nehaej2/ece445_team39/Lab Notebooks/Ian/Written_notes.md

# Written Notes

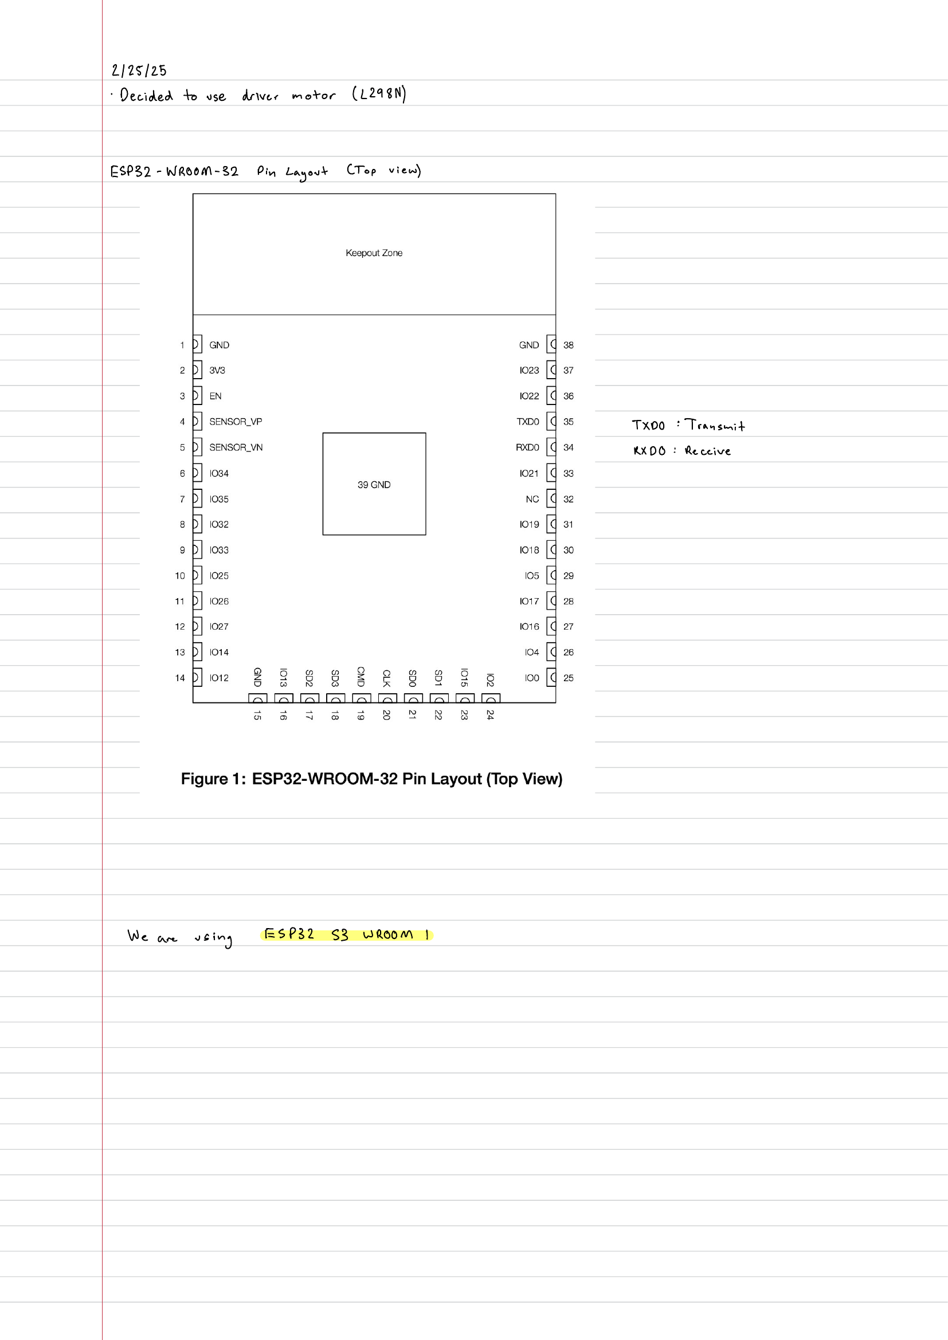
[picture p7: Lab Notebooks/Ian/Written_notes/page_1.png]
Page 1
  
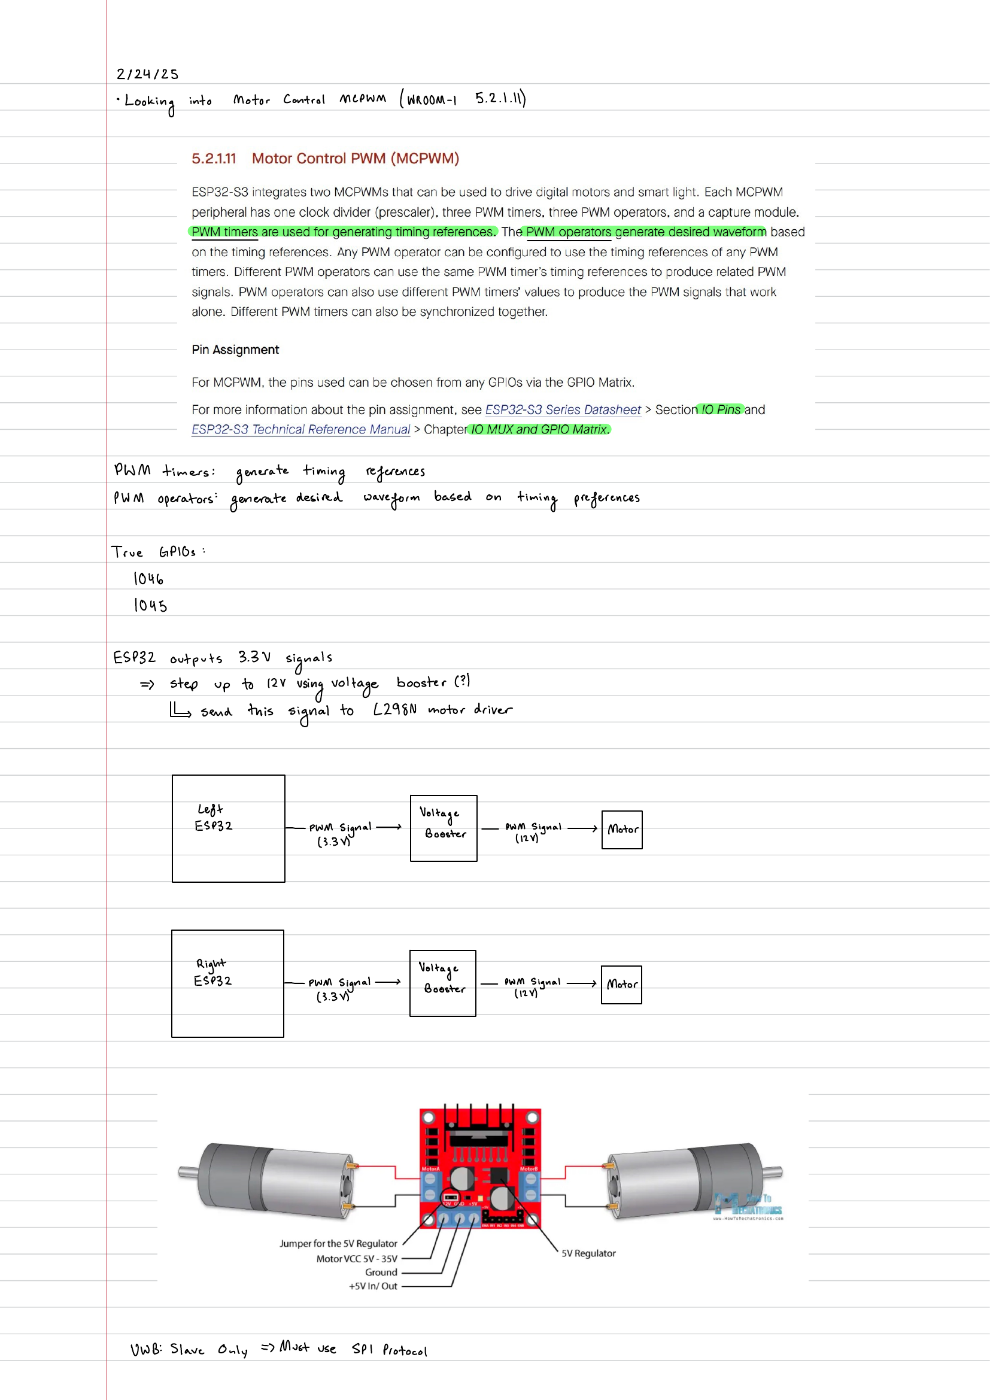
[picture p8: Lab Notebooks/Ian/Written_notes/page_2.png]
Page 2
  
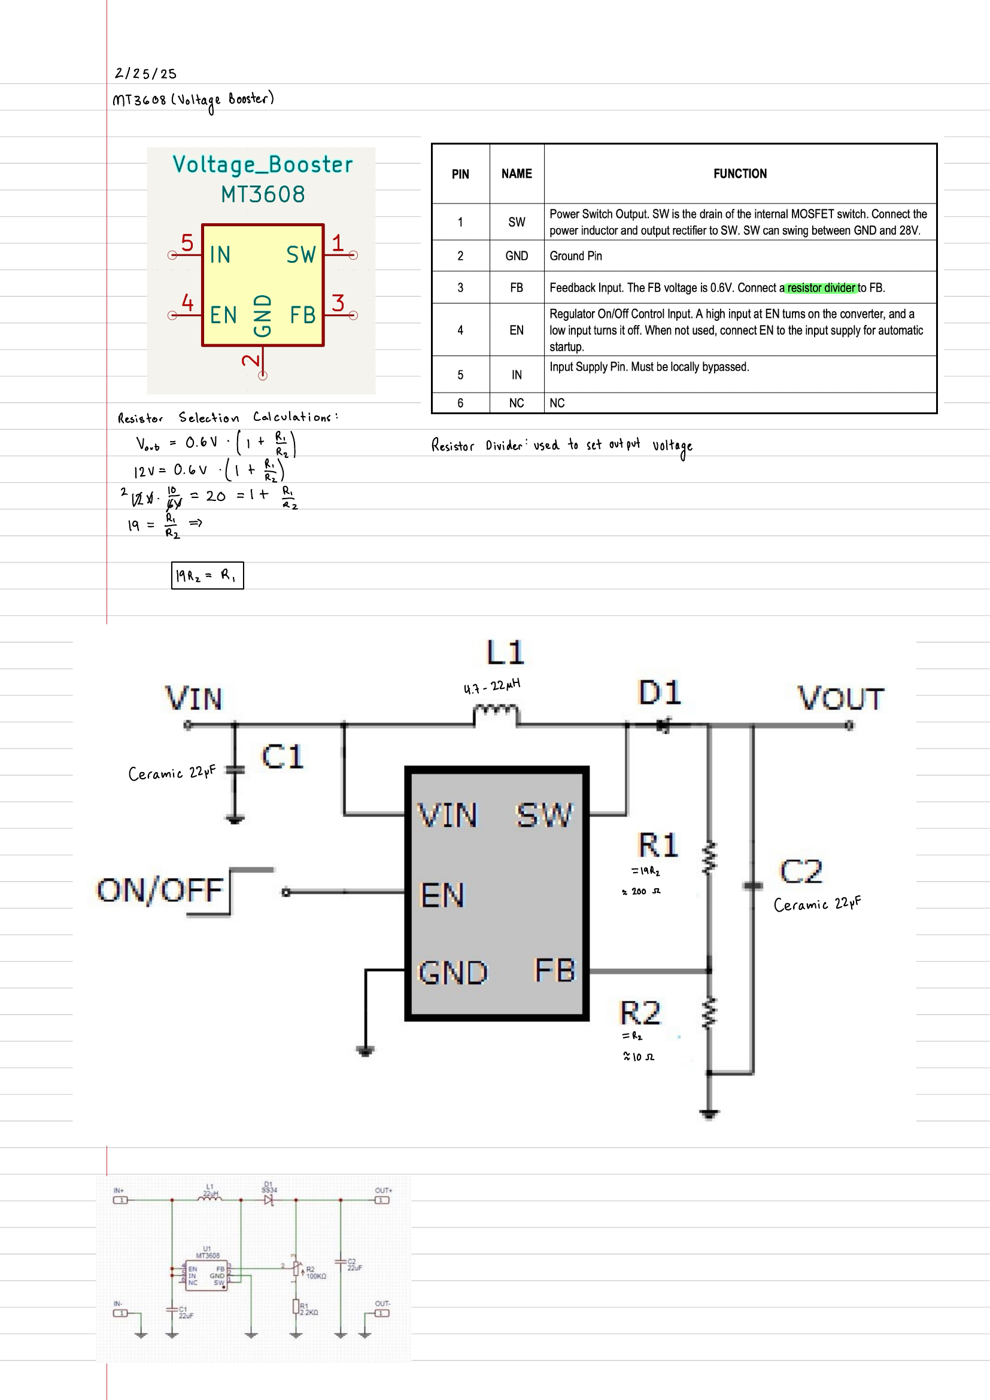
[picture p9: Lab Notebooks/Ian/Written_notes/page_3.png]
Page 3
  
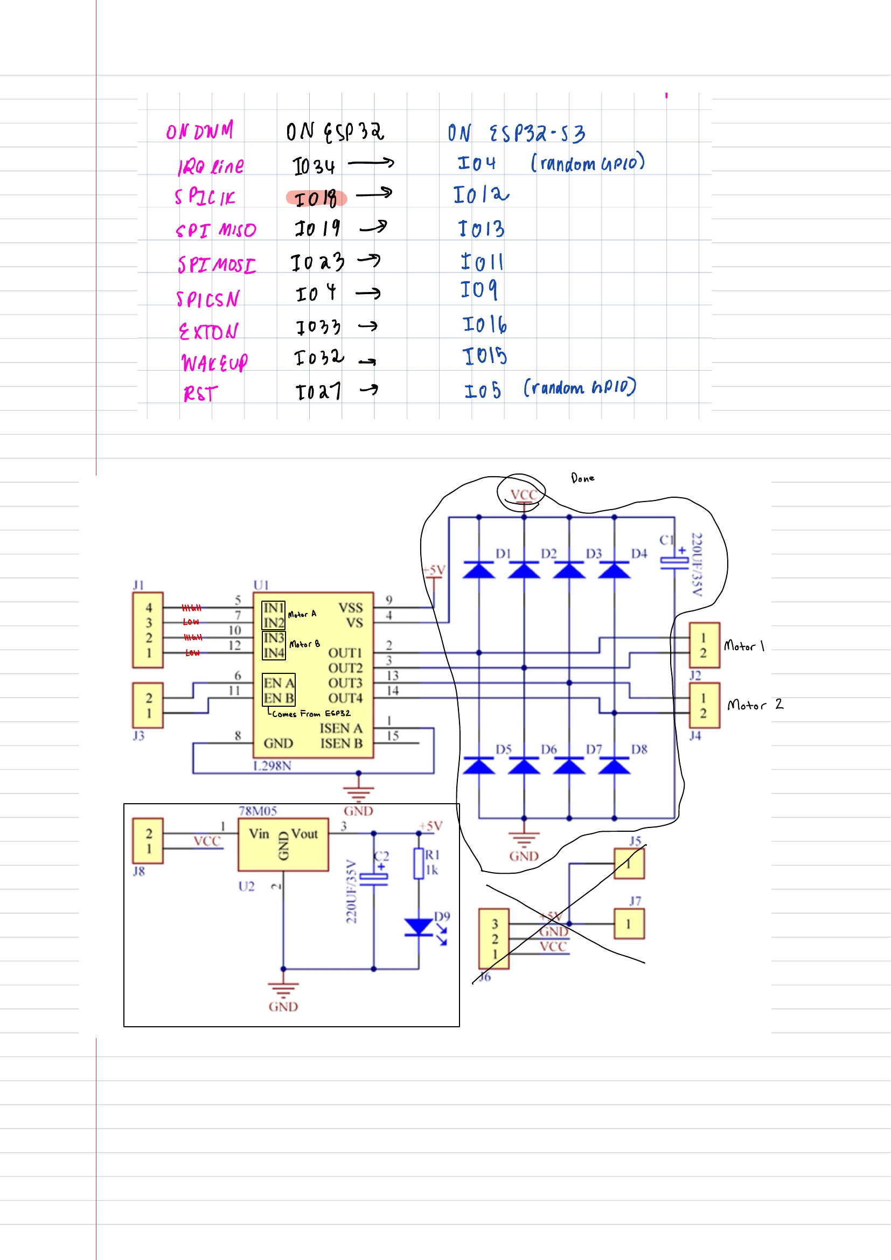
[picture p10: Lab Notebooks/Ian/Written_notes/page_4.png]
Page 4
  
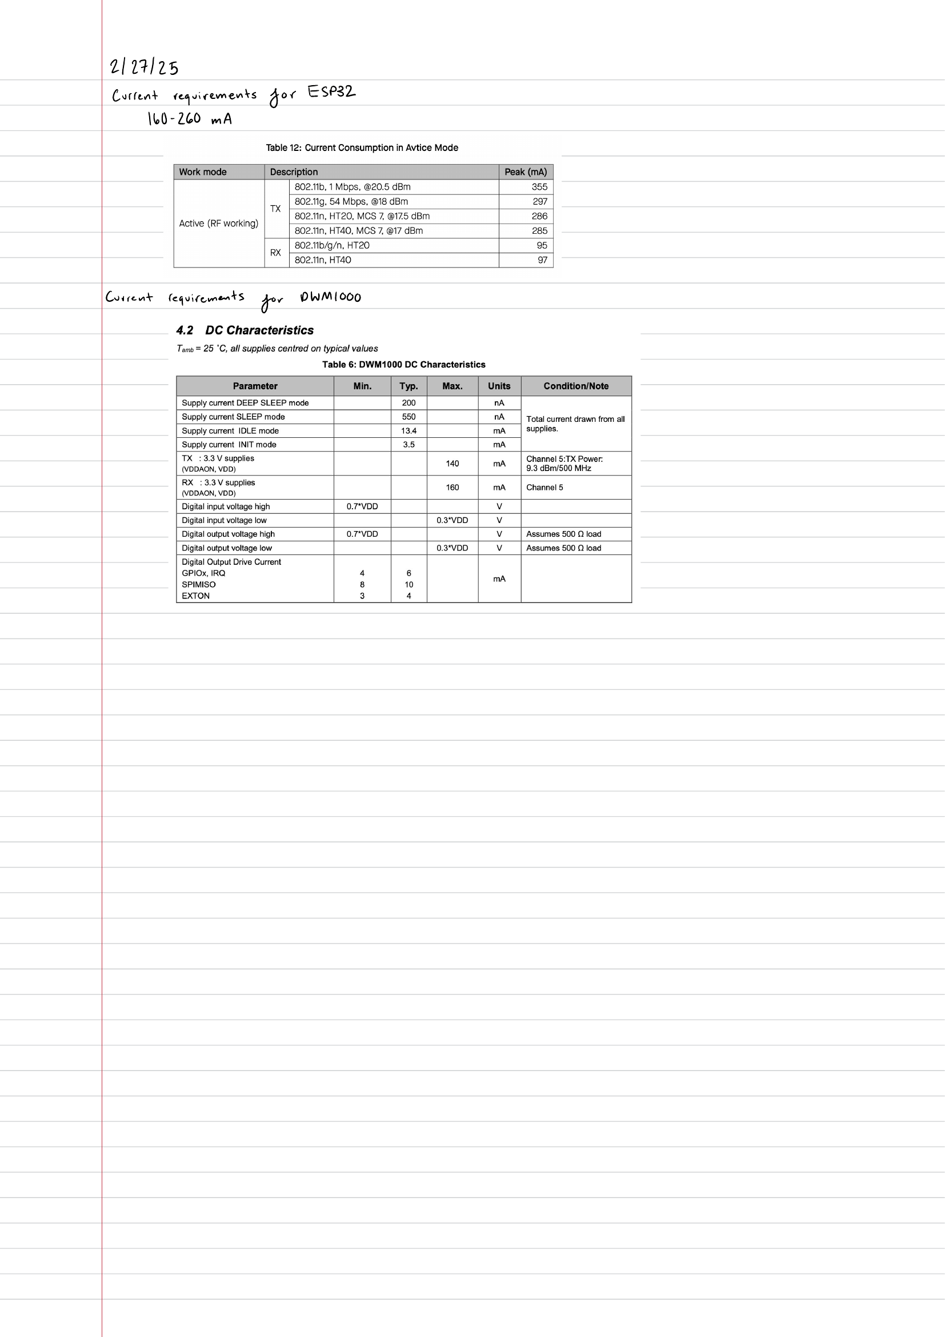
[picture p11: Lab Notebooks/Ian/Written_notes/page_5.png]
Page 5
  
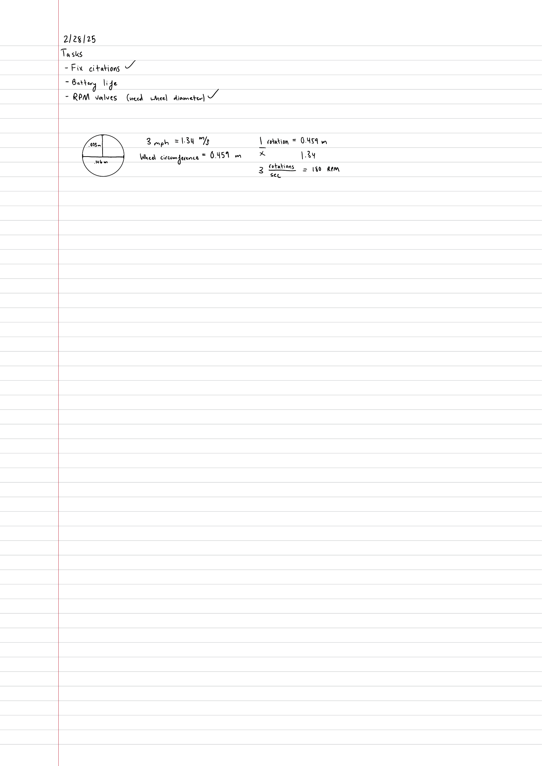
[picture p12: Lab Notebooks/Ian/Written_notes/page_6.png]
Page 6
  
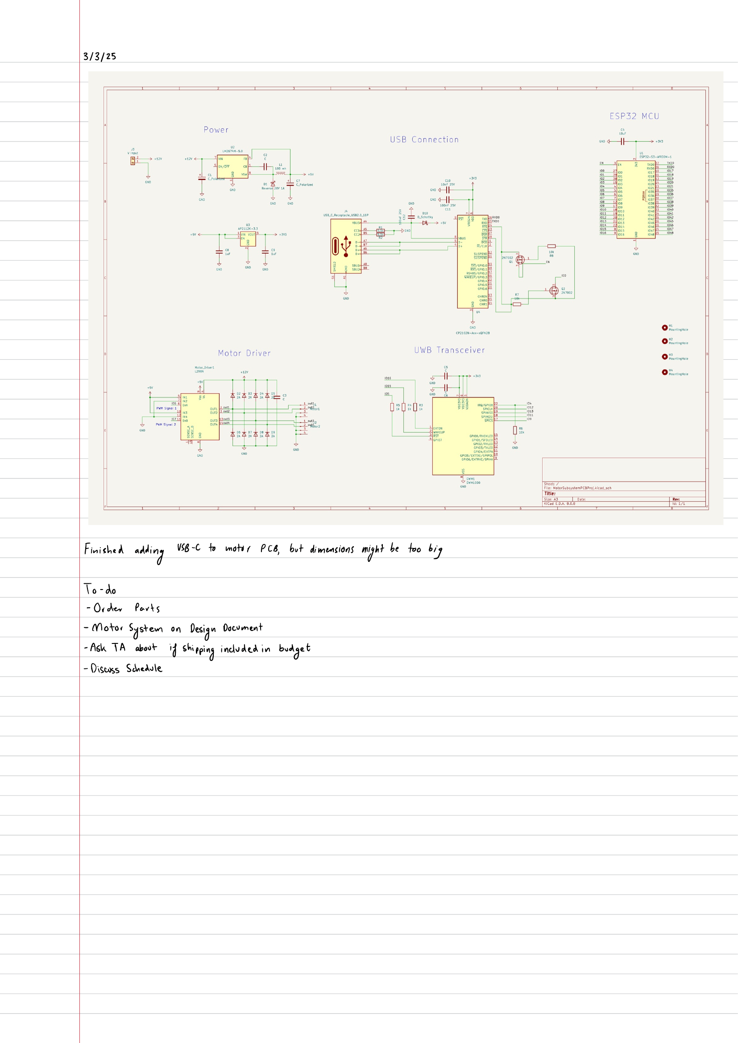
[picture p13: Lab Notebooks/Ian/Written_notes/page_7.png]
Page 7
  
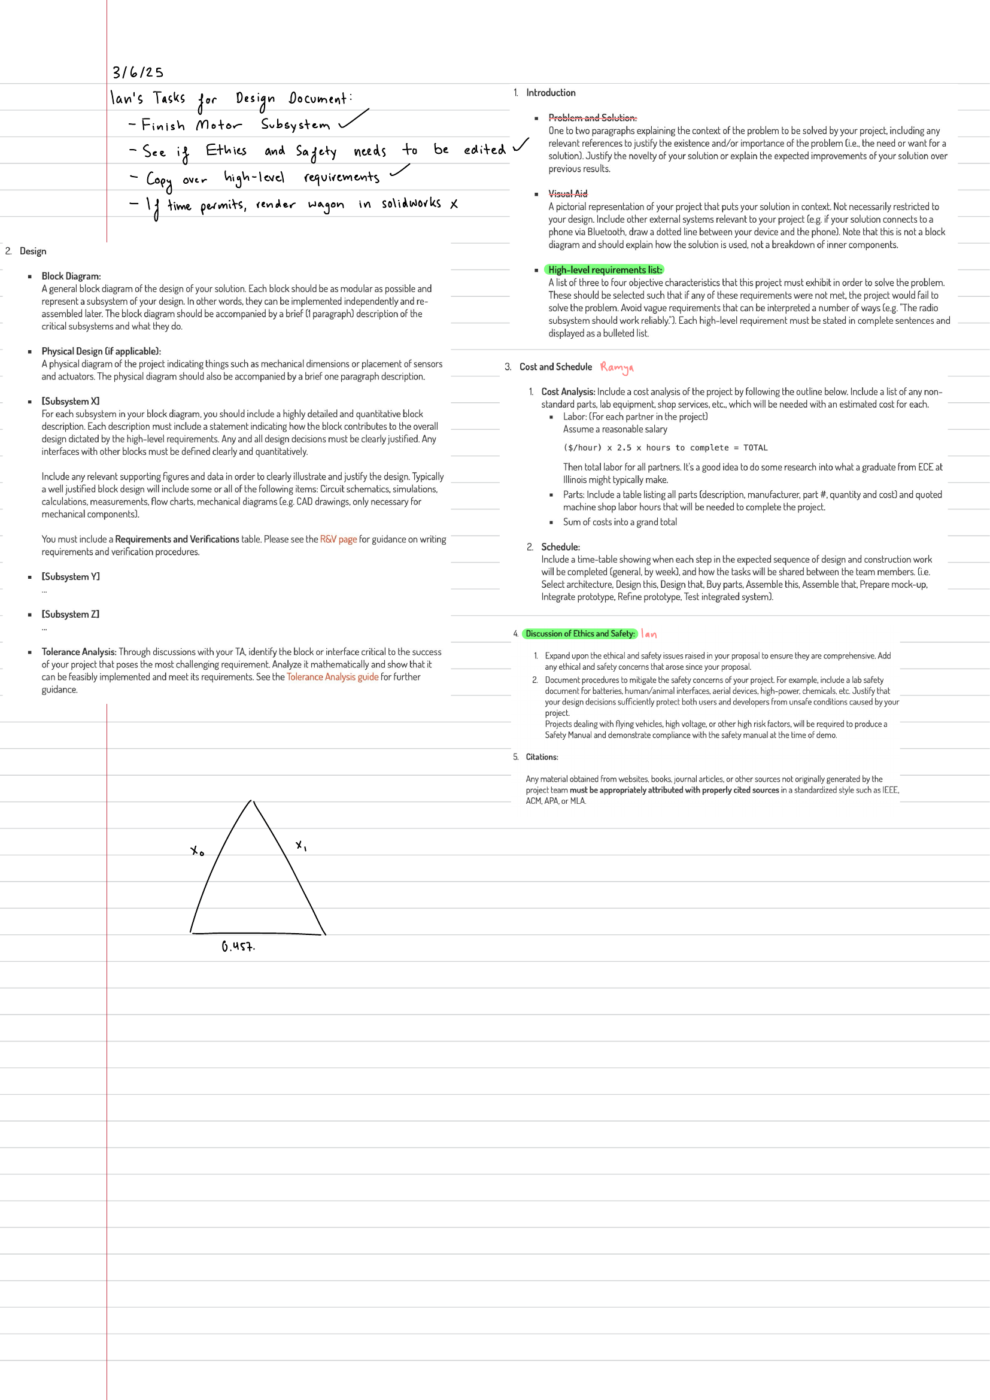
[picture p14: Lab Notebooks/Ian/Written_notes/page_8.png]
Page 8
  
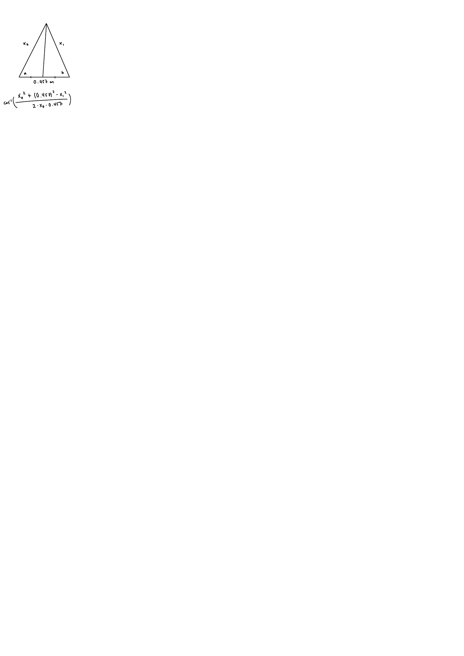
[picture p15: Lab Notebooks/Ian/Written_notes/page_9.png]
Page 9
  
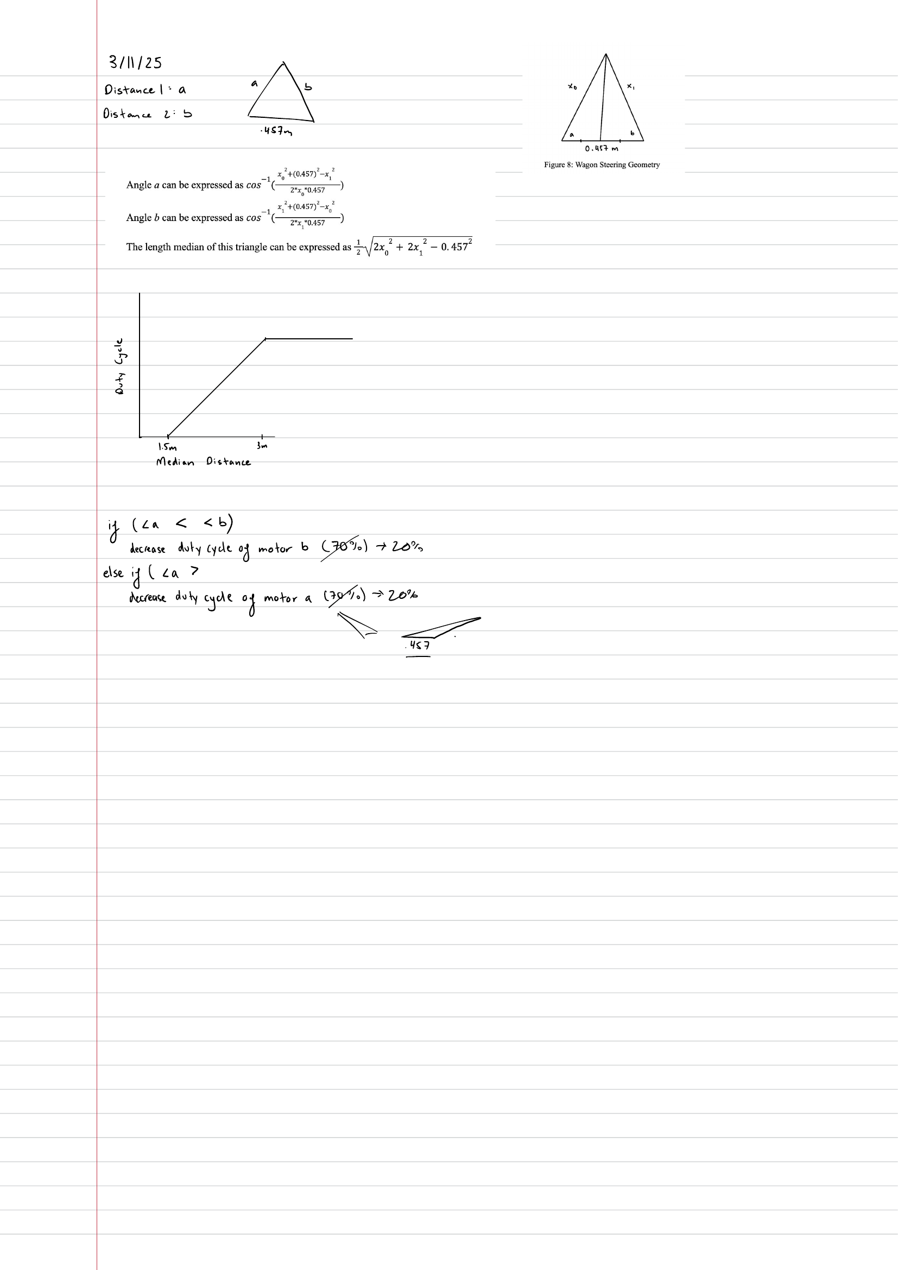
[picture p16: Lab Notebooks/Ian/Written_notes/page_10.png]
Page 10
  
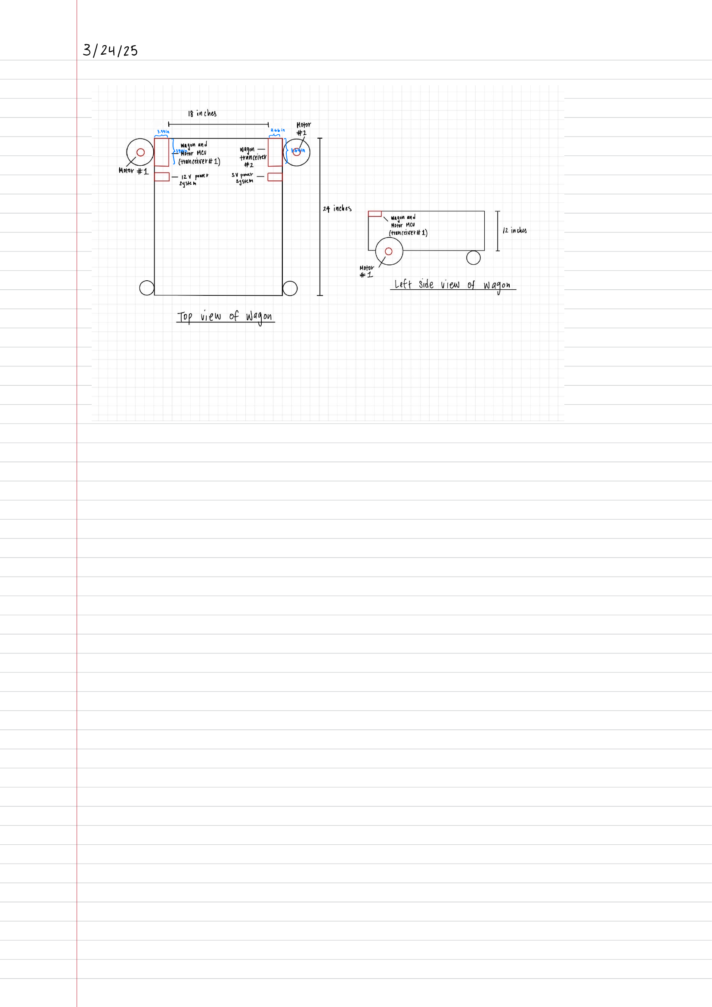
[picture p17: Lab Notebooks/Ian/Written_notes/page_11.png]
Page 11
  
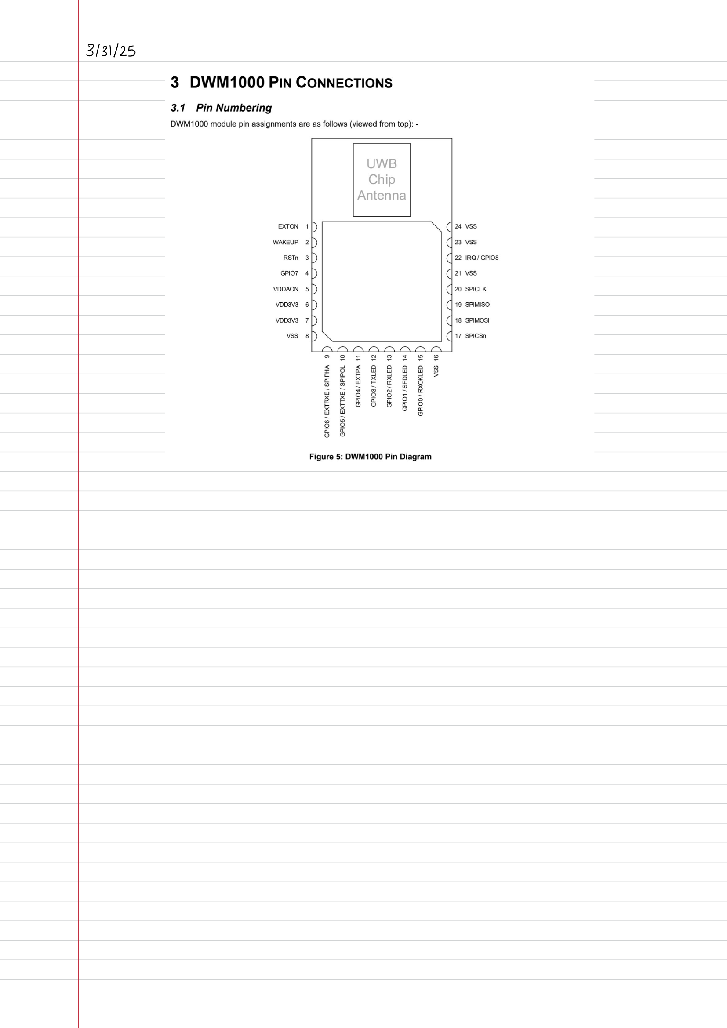
[picture p18: Lab Notebooks/Ian/Written_notes/page_12.png]
Page 12
  
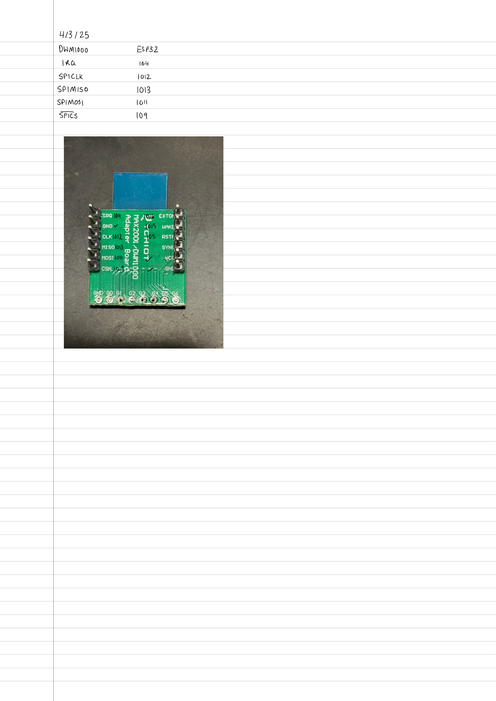
[picture p19: Lab Notebooks/Ian/Written_notes/page_13.png]
Page 13
  
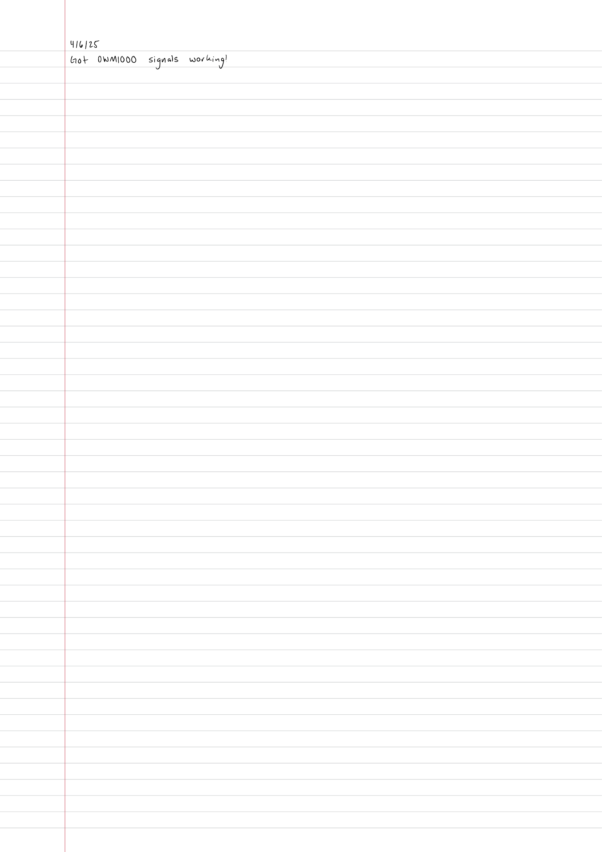
[picture p20: Lab Notebooks/Ian/Written_notes/page_14.png]
Page 14
  
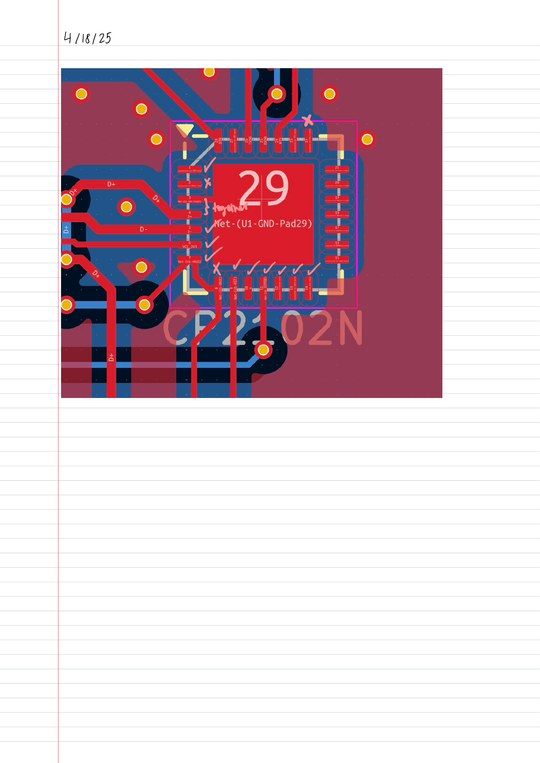
[picture p21: Lab Notebooks/Ian/Written_notes/page_15.png]
Page 15
  
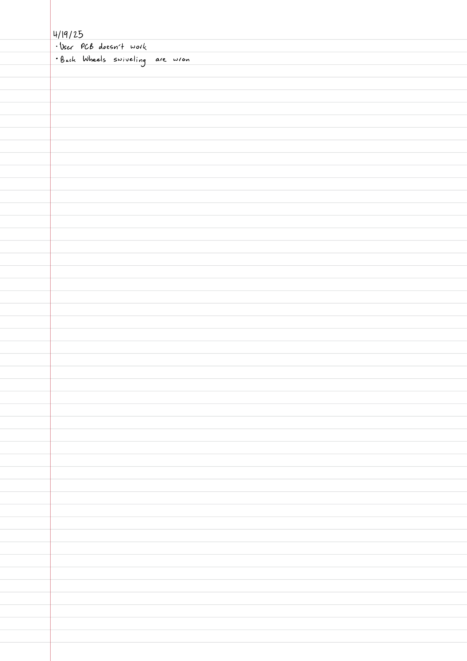
[picture p22: Lab Notebooks/Ian/Written_notes/page_16.png]
Page 16
  
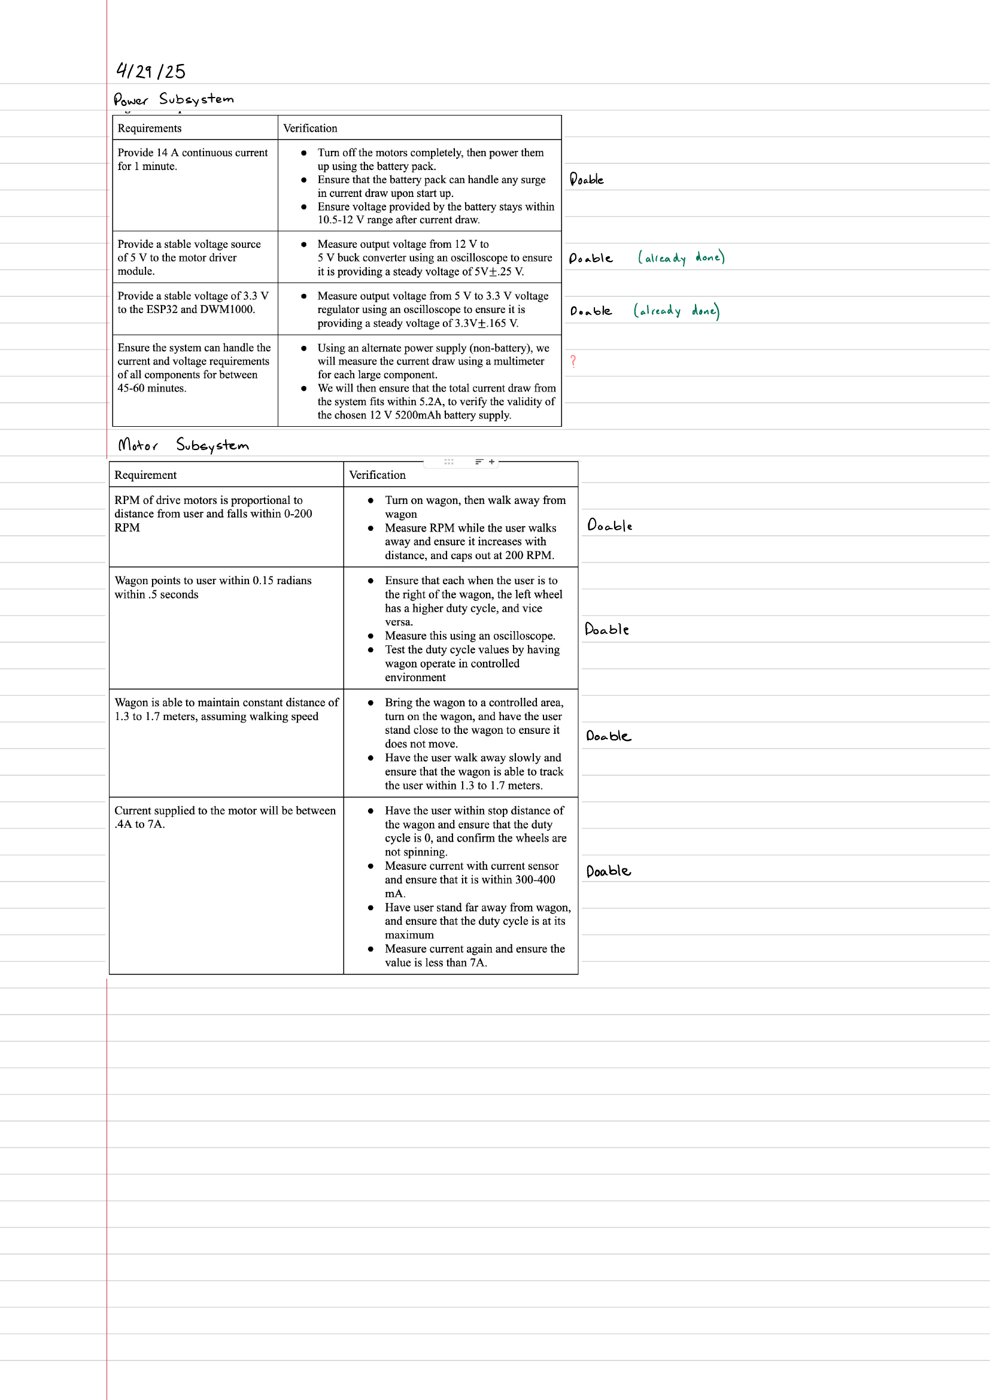
[picture p23: Lab Notebooks/Ian/Written_notes/page_17.png]
Page 17
  
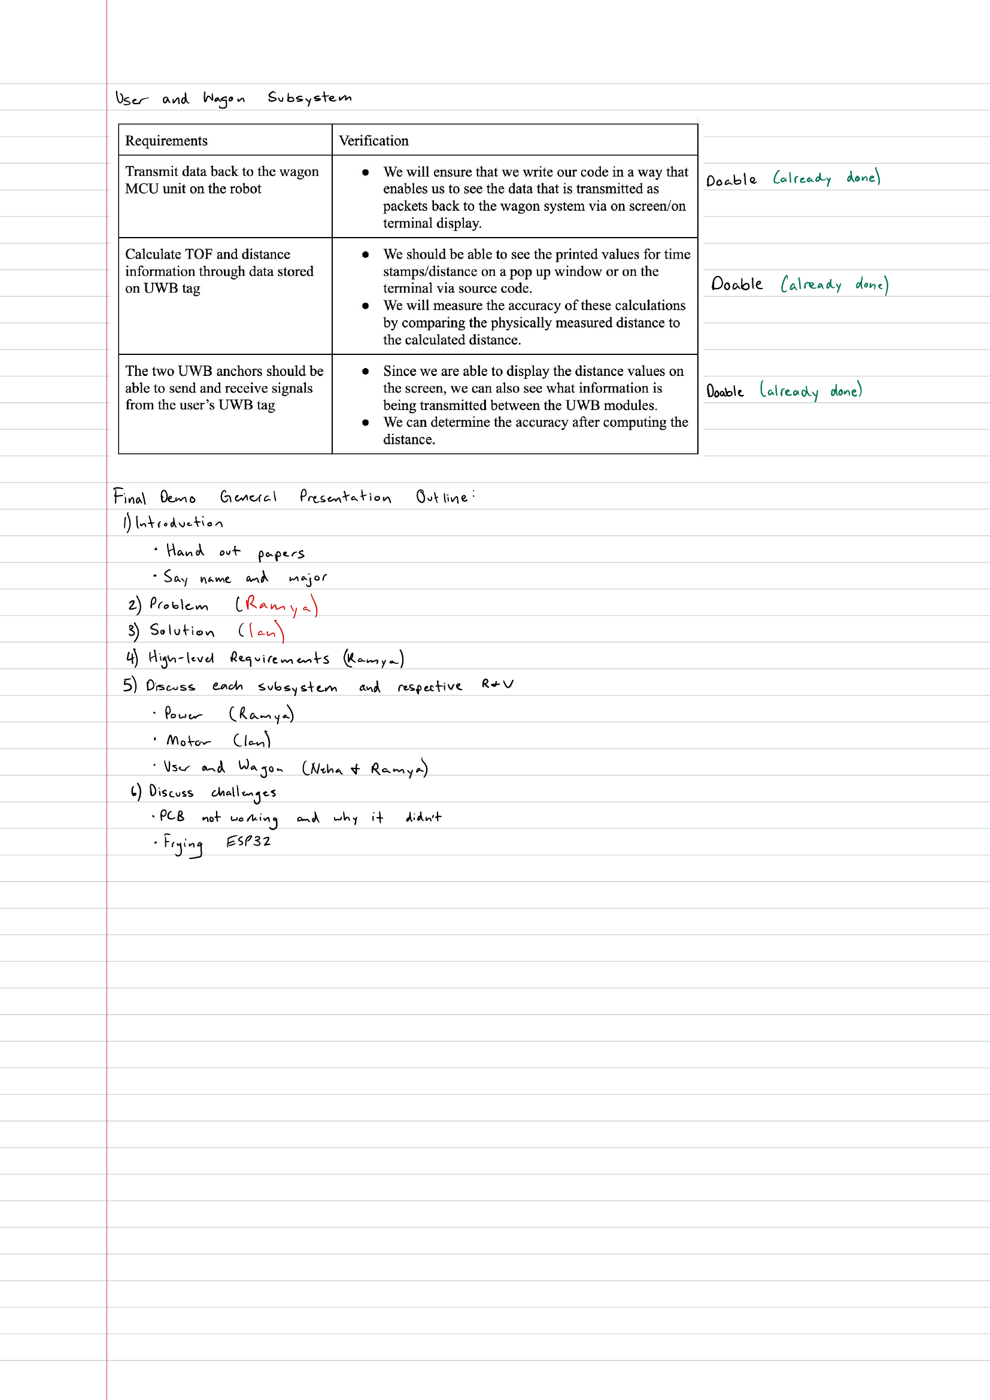
[picture p24: Lab Notebooks/Ian/Written_notes/page_18.png]
Page 18
  
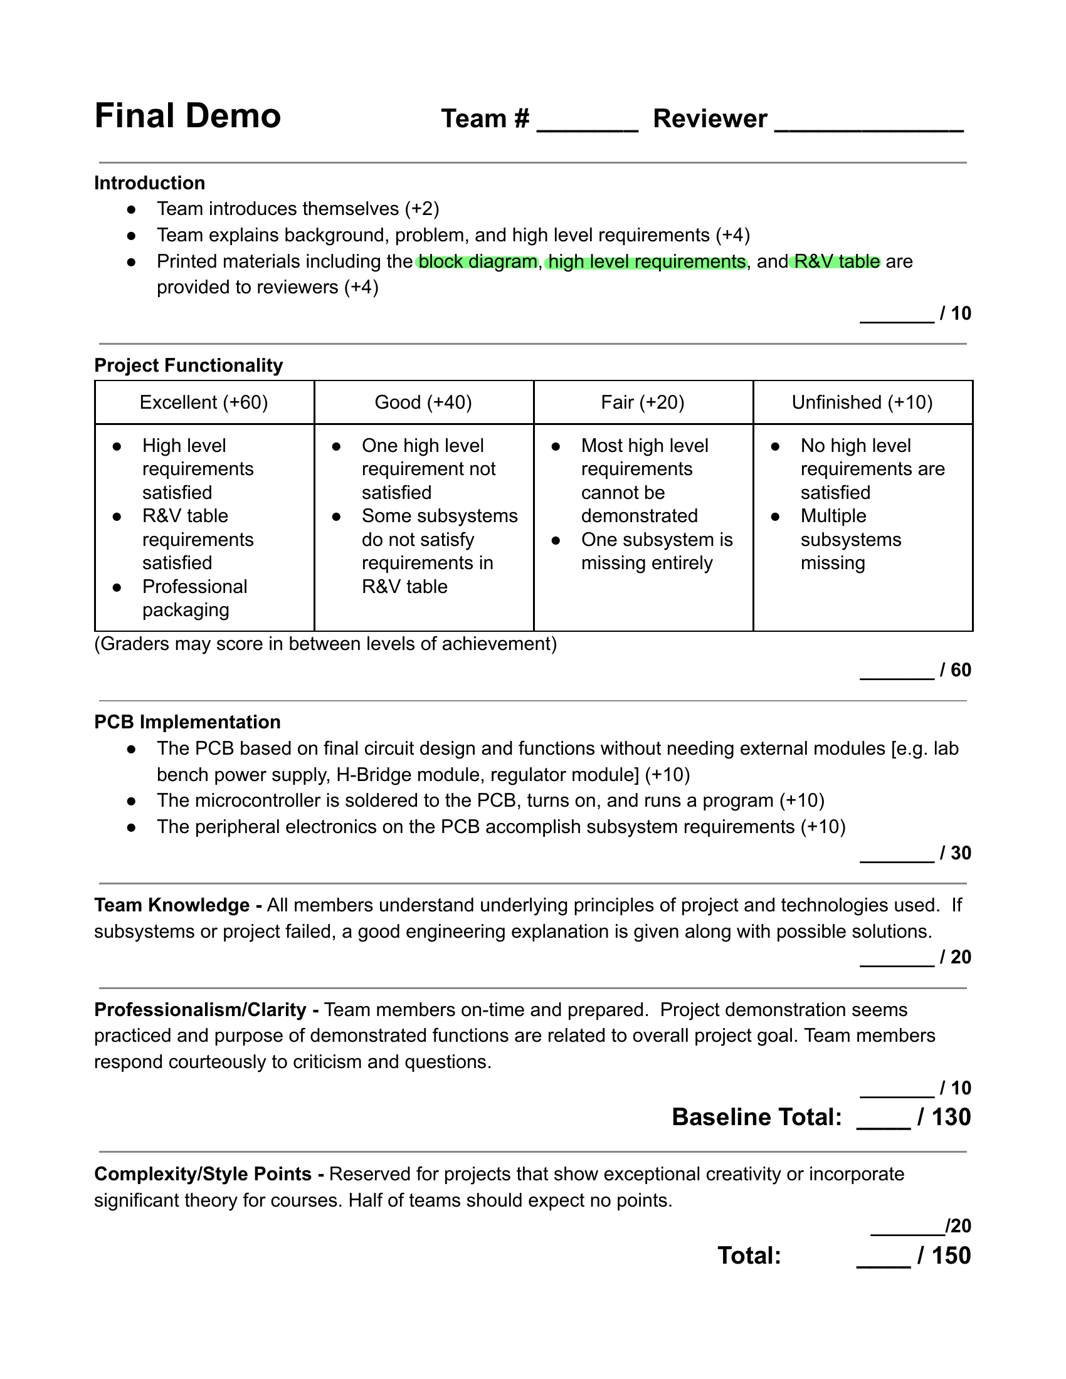
[picture p25: Lab Notebooks/Ian/Written_notes/page_19.png]
Page 19
  
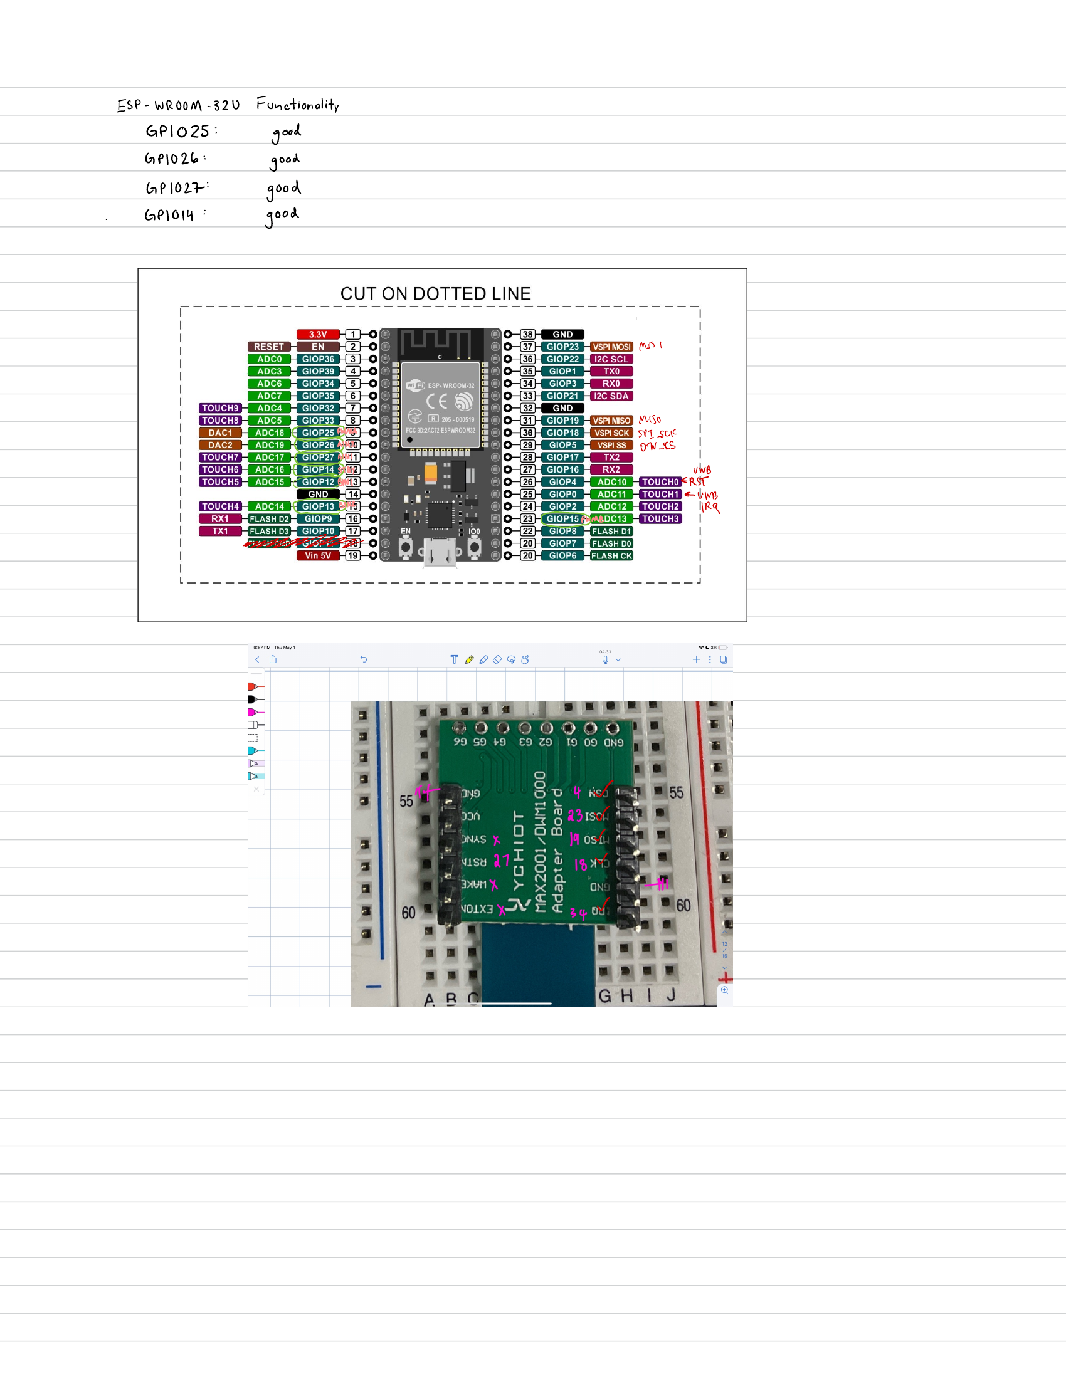
[picture p26: Lab Notebooks/Ian/Written_notes/page_20.png]
Page 20
