nehaej2/ece445_team39/Lab Notebooks/Neha/Wrtitten_notes.md

# Written Notes

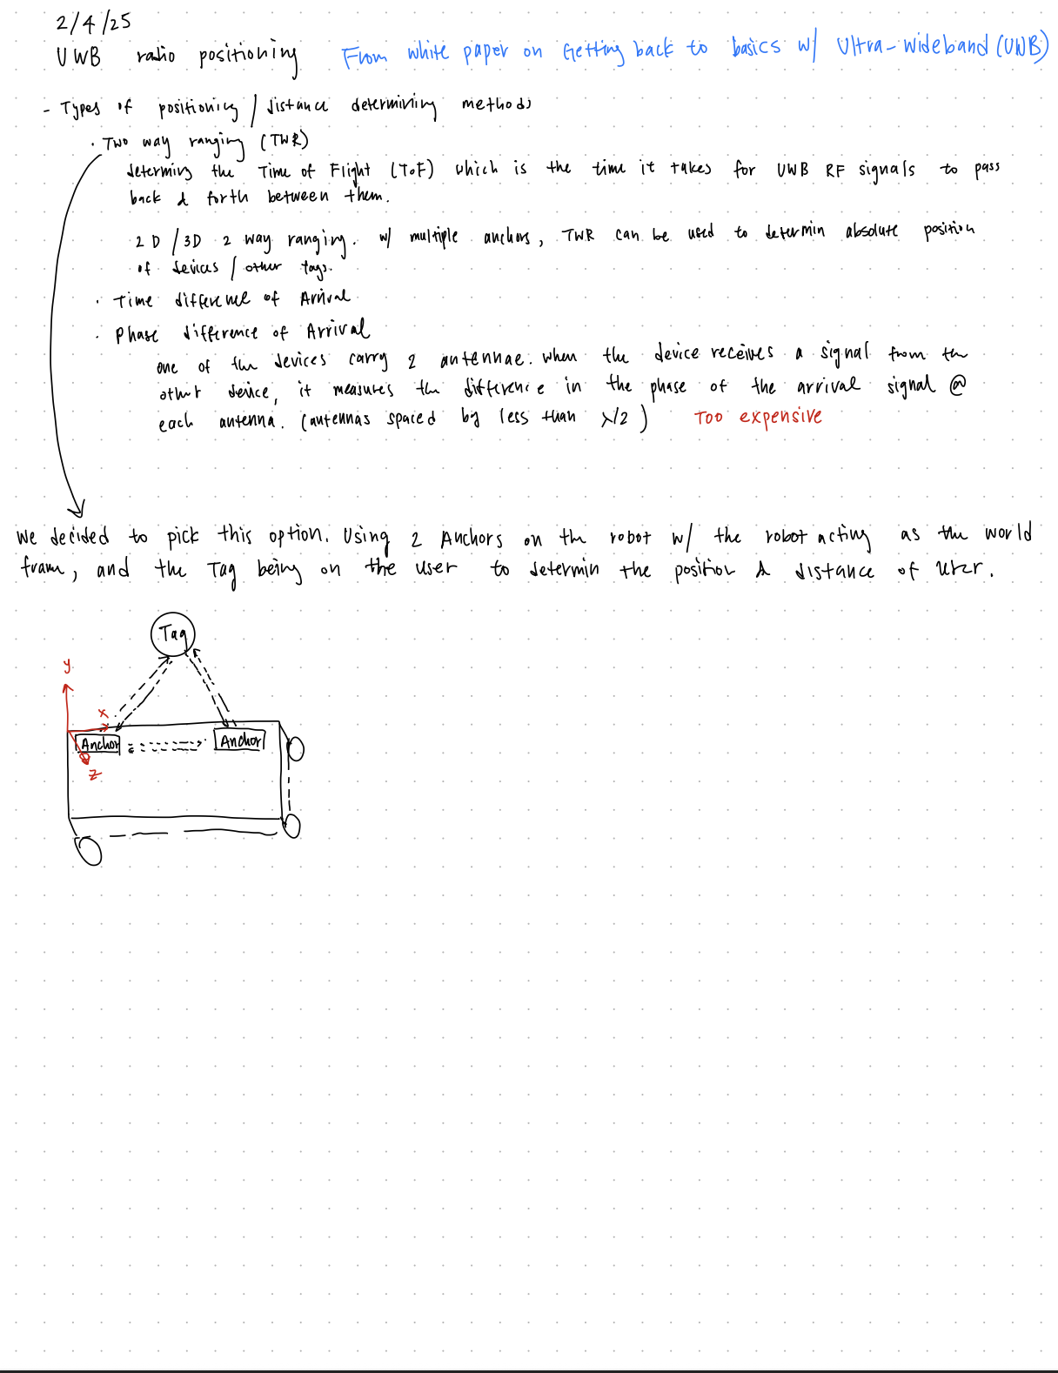
[picture p27: Lab Notebooks/Neha/Written_notes/Page_1.png]


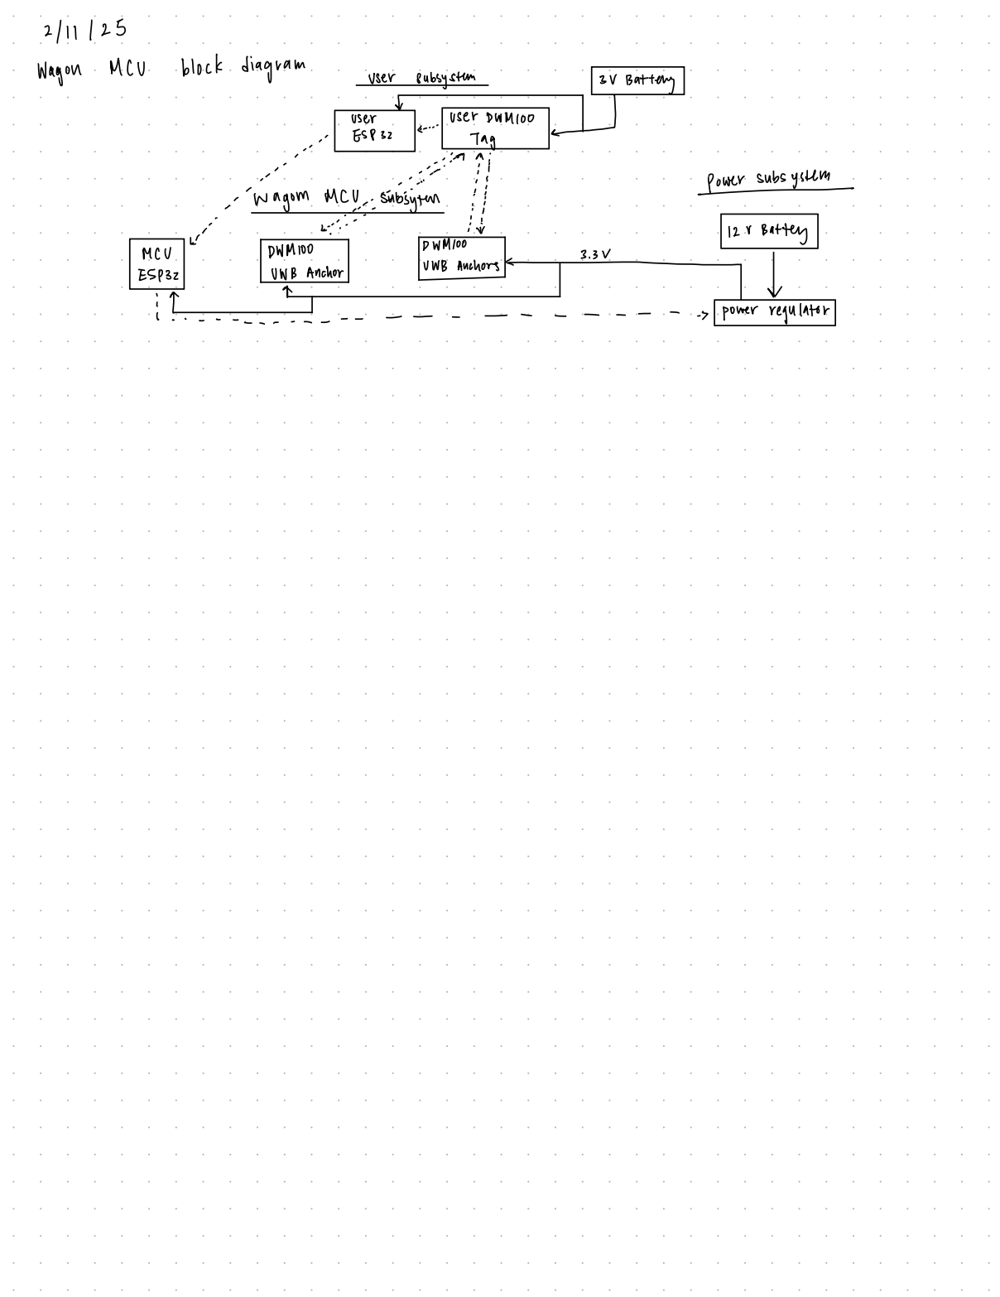
[picture p28: Lab Notebooks/Neha/Written_notes/Page_2.png]


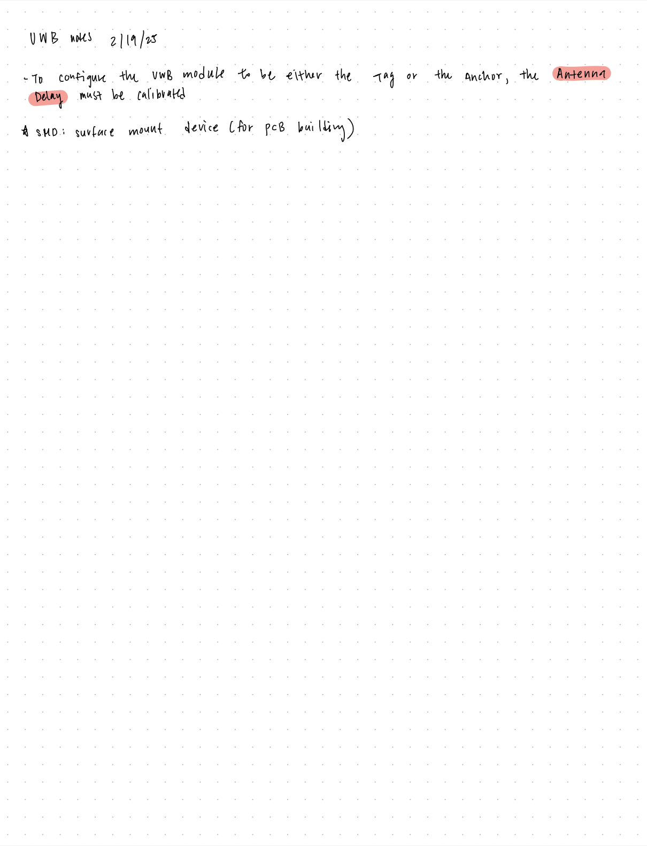
[picture p29: Lab Notebooks/Neha/Written_notes/Page_3.png]


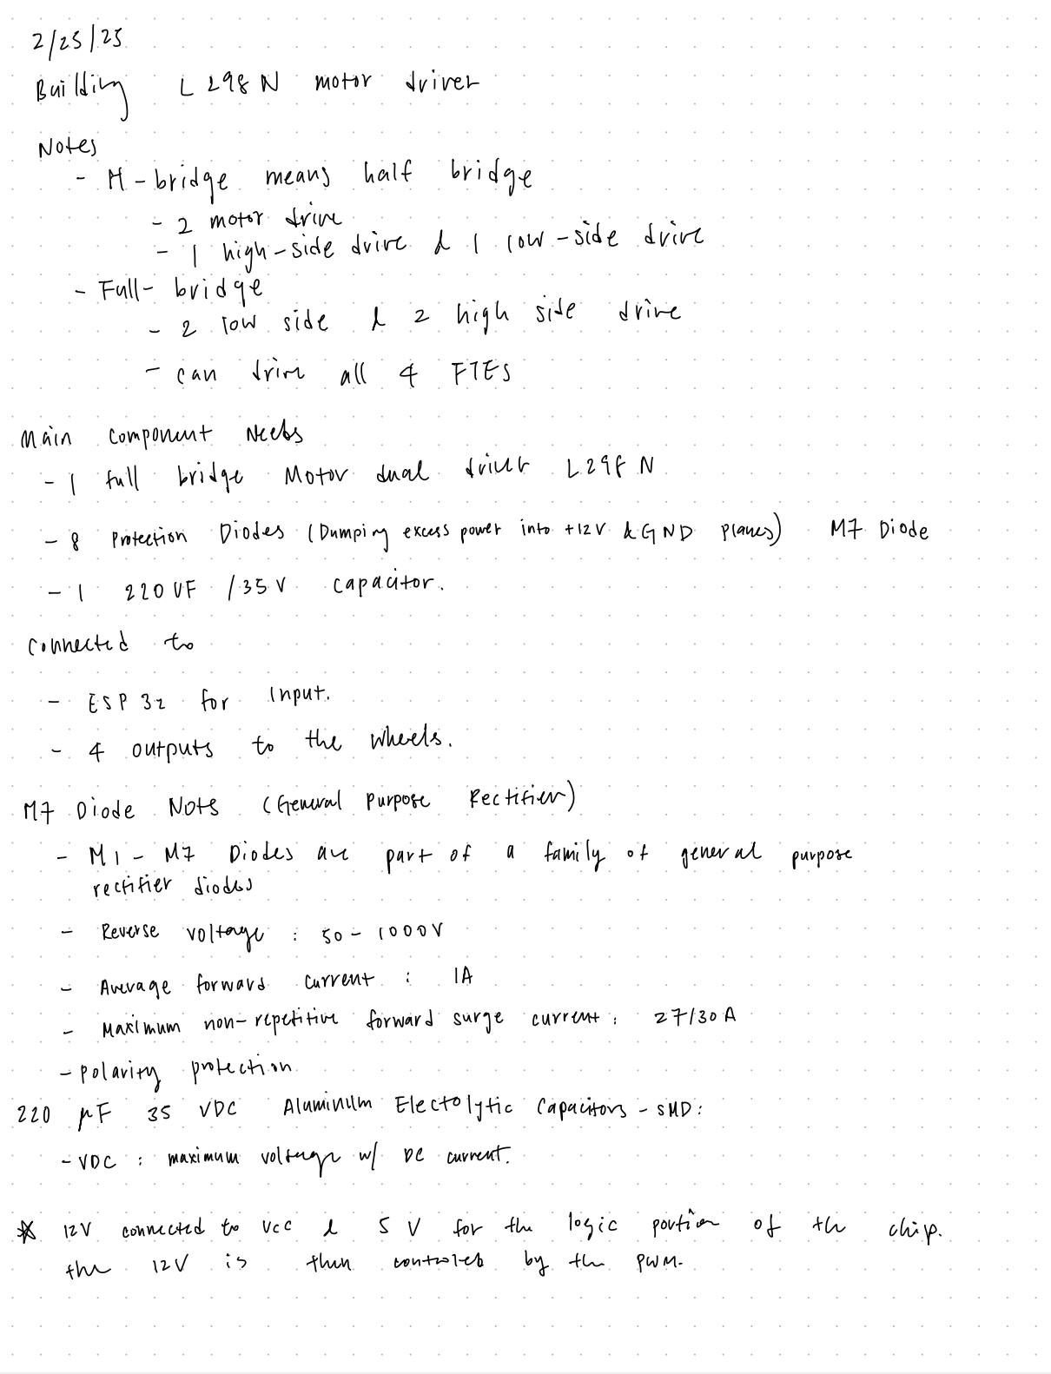
[picture p30: Lab Notebooks/Neha/Written_notes/Page_4.png]


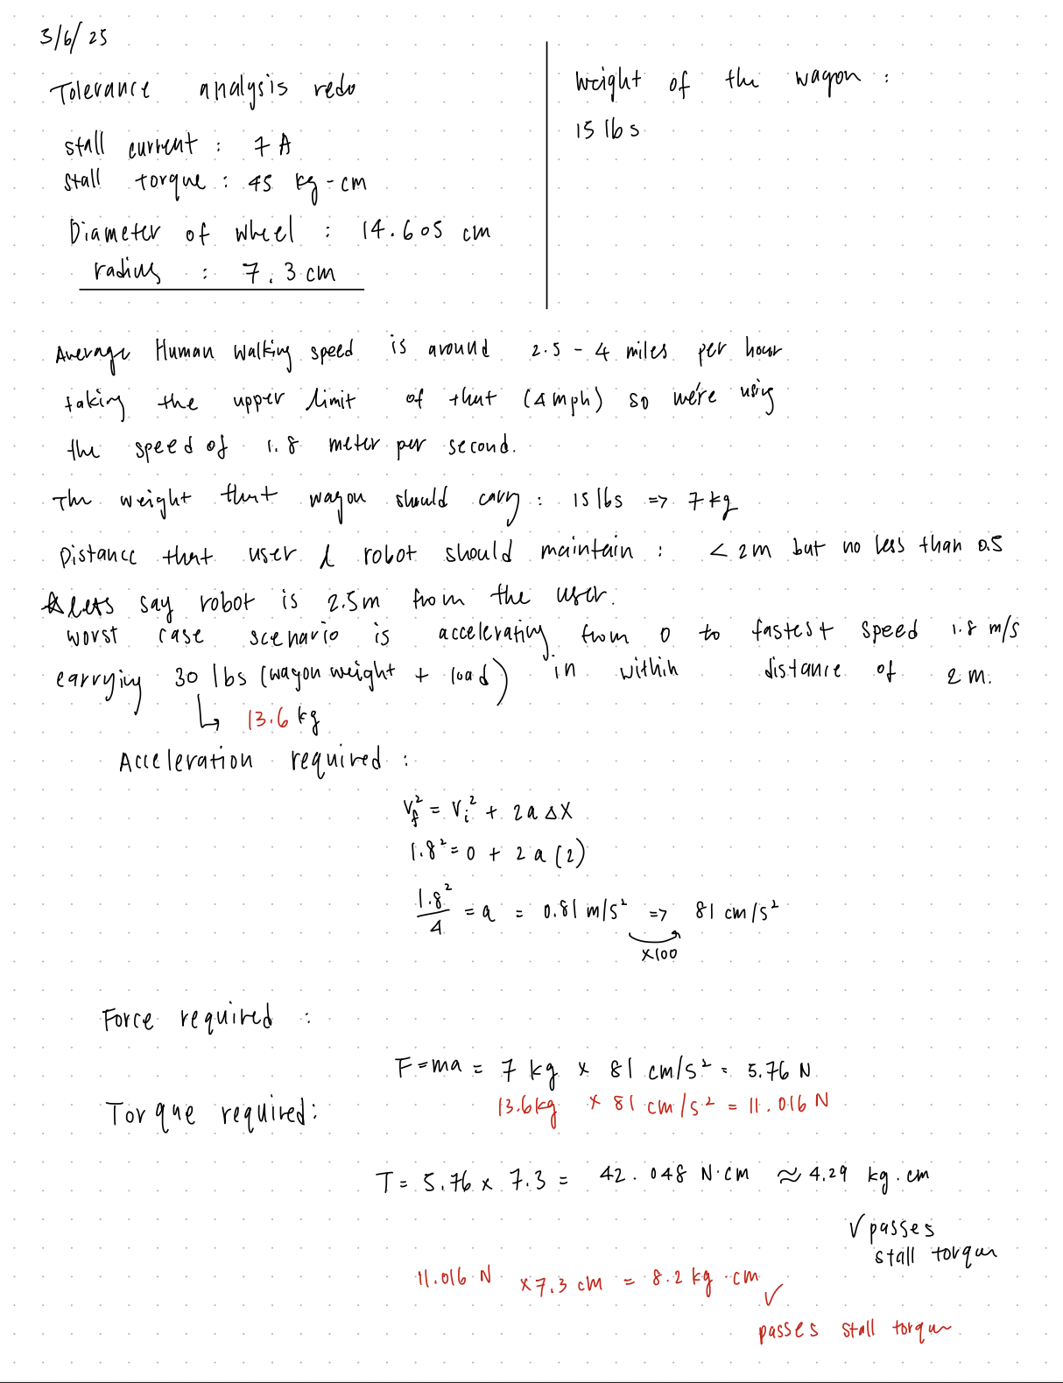
[picture p31: Lab Notebooks/Neha/Written_notes/Page_5.png]


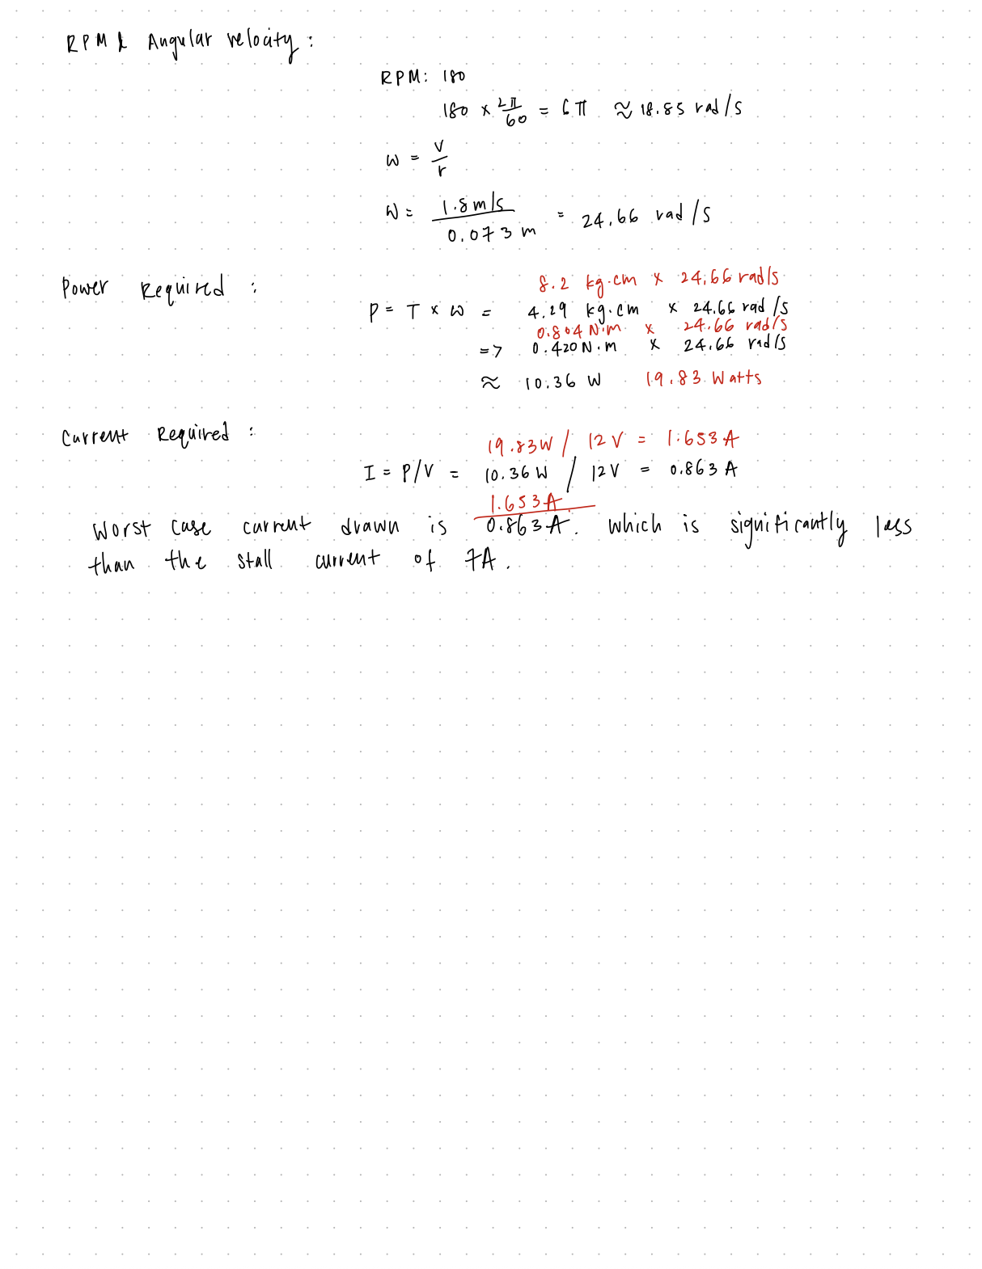
[picture p32: Lab Notebooks/Neha/Written_notes/Page_6.png]


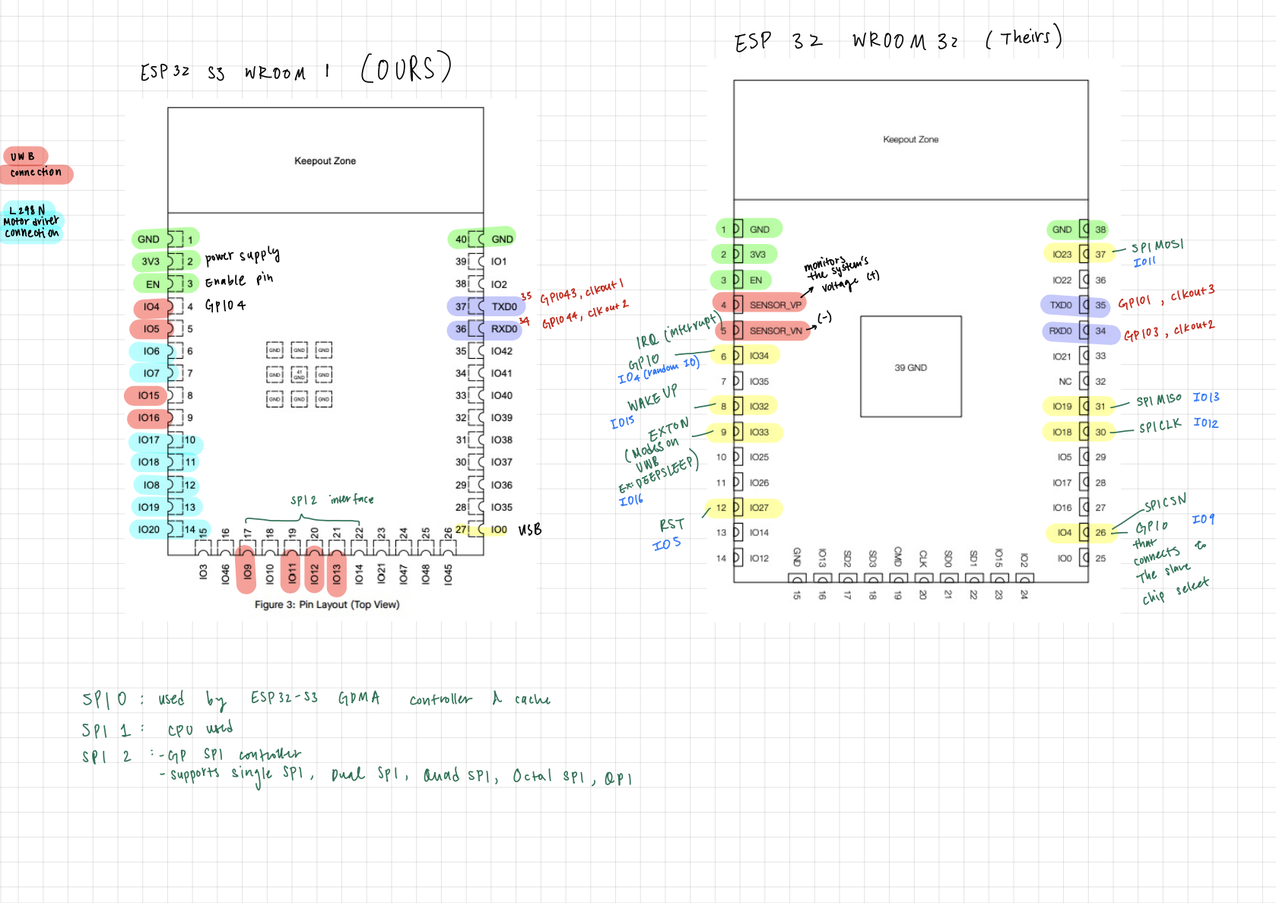
[picture p33: Lab Notebooks/Neha/Written_notes/Page_7.png]


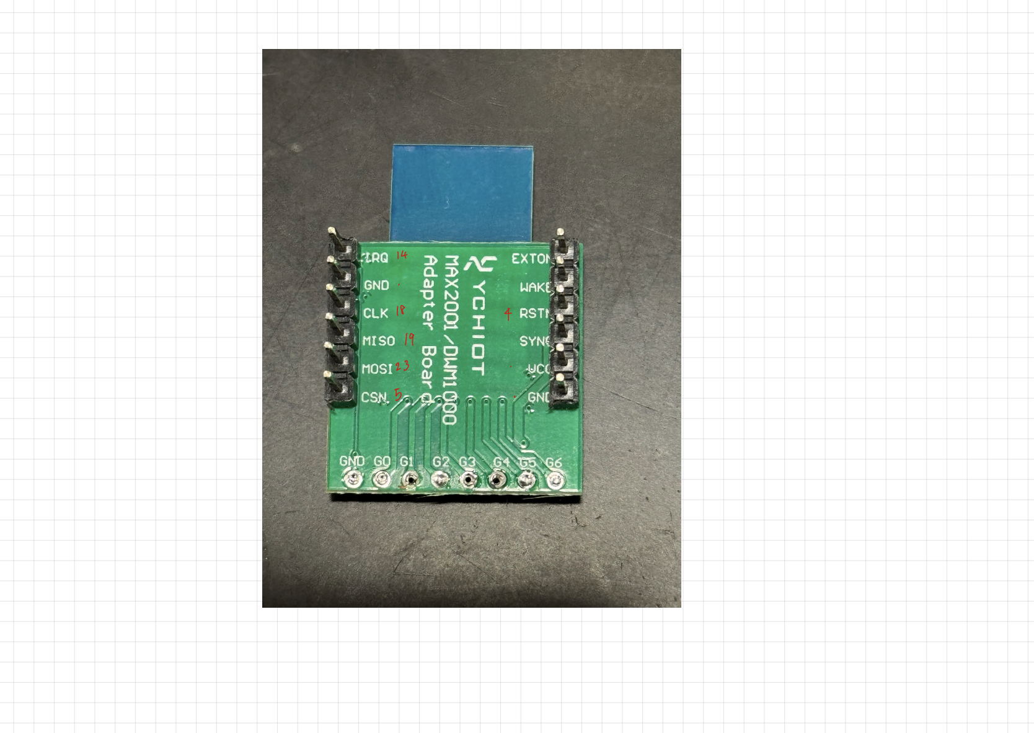
[picture p34: Lab Notebooks/Neha/Written_notes/Page_8.png]


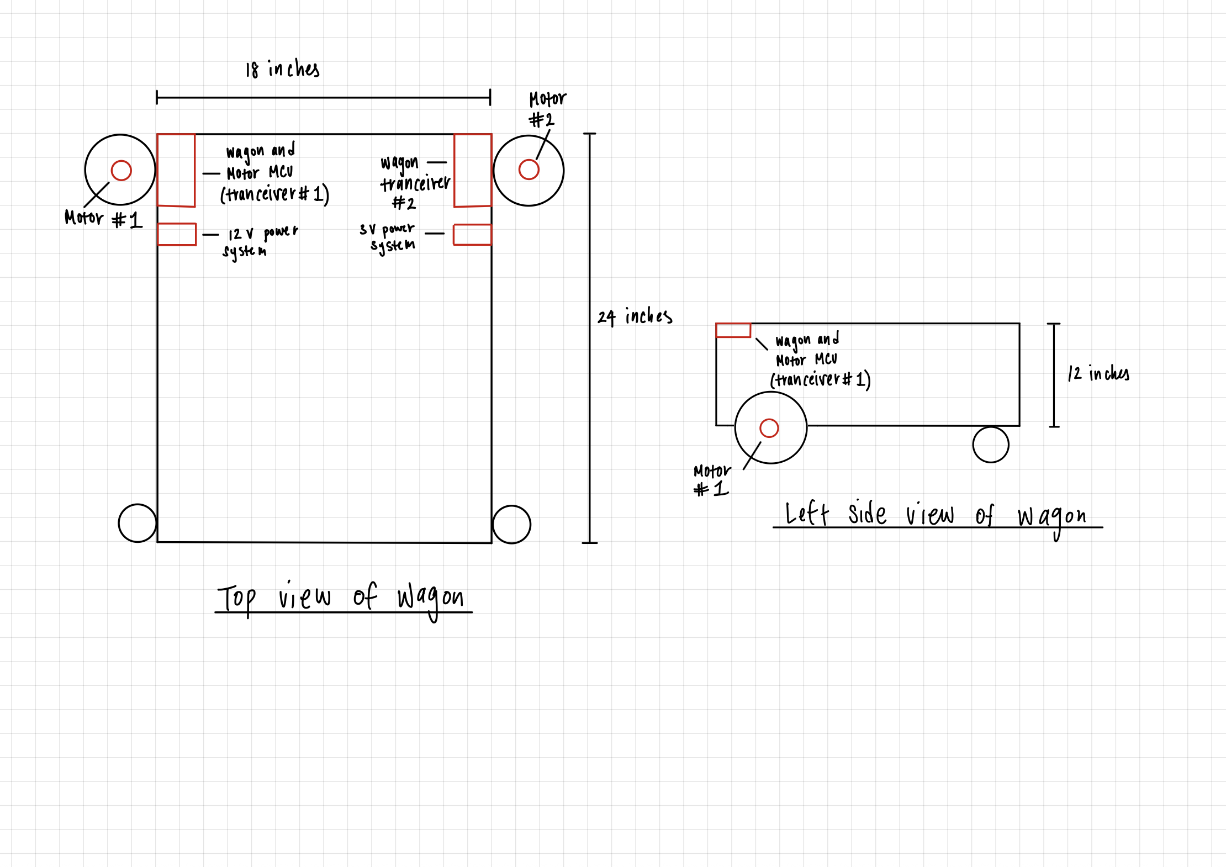
[picture p35: Lab Notebooks/Neha/Written_notes/Page_9.png]


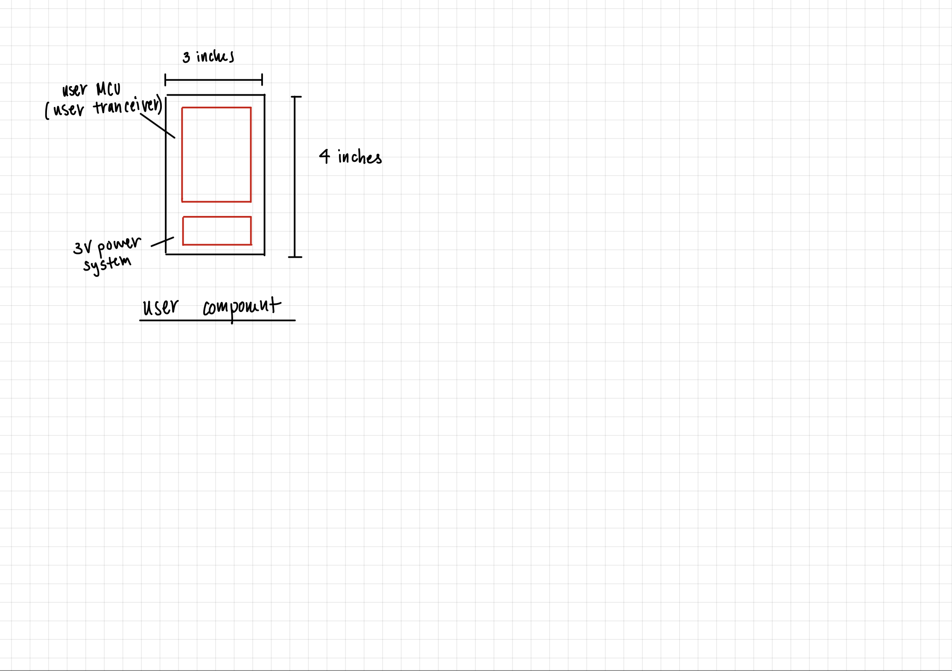
[picture p36: Lab Notebooks/Neha/Written_notes/Page_10.png]
