nehaej2/ece445_team39/Lab Notebooks/Ramya/Written Notes.md

# Written Notes

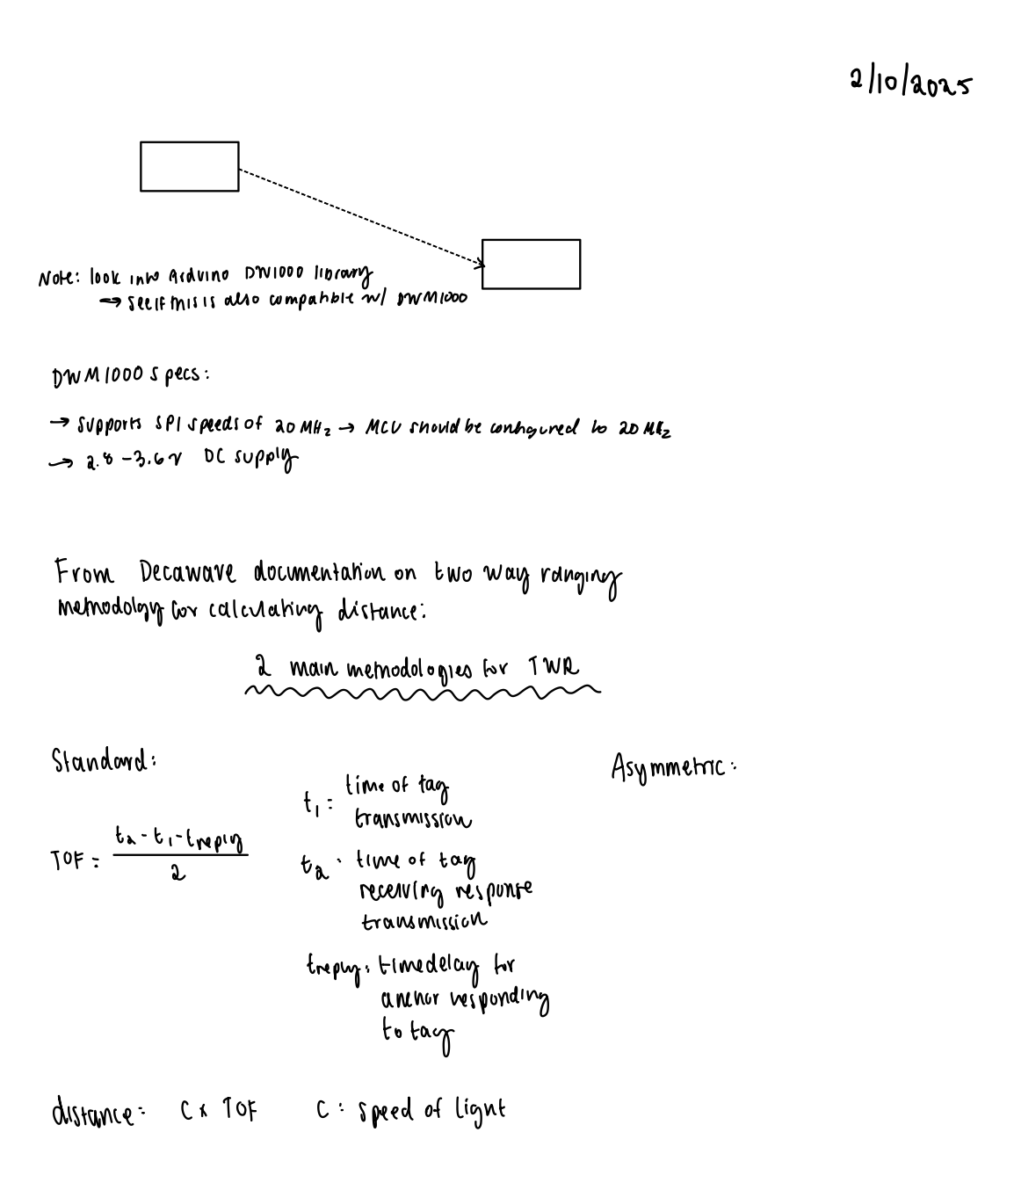
[picture p37: Lab Notebooks/Ramya/Images/Written Notes/Page_1.png]


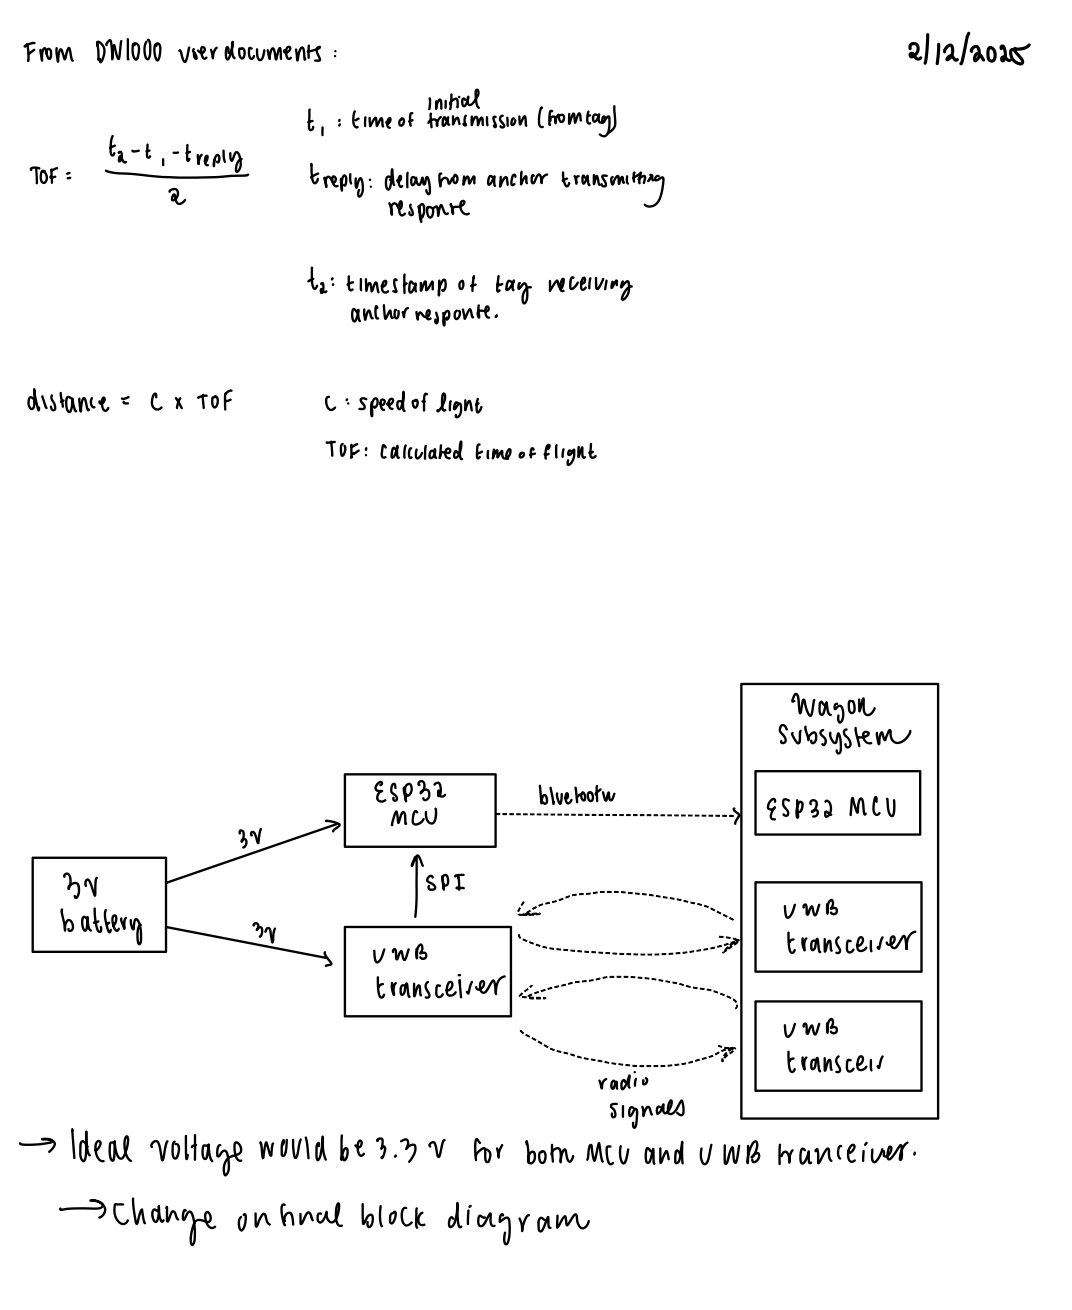
[picture p38: Lab Notebooks/Ramya/Images/Written Notes/Page_2.png]


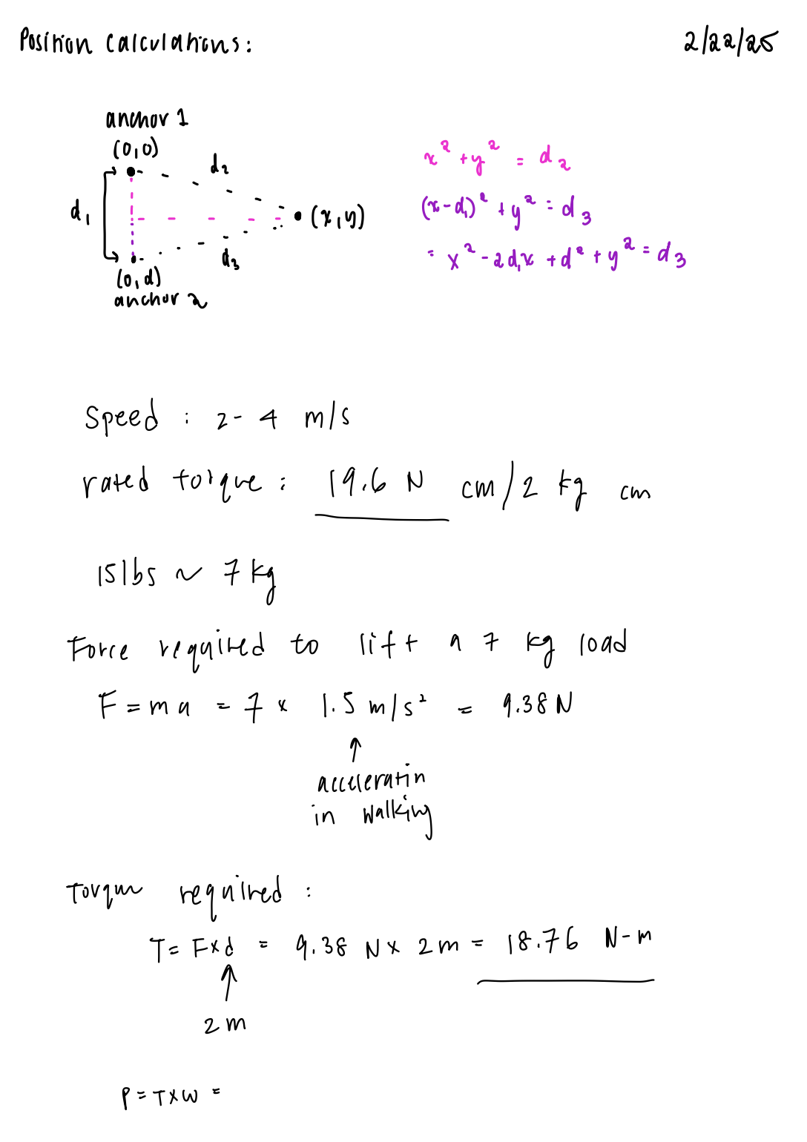
[picture p39: Lab Notebooks/Ramya/Images/Written Notes/Page_3.png]


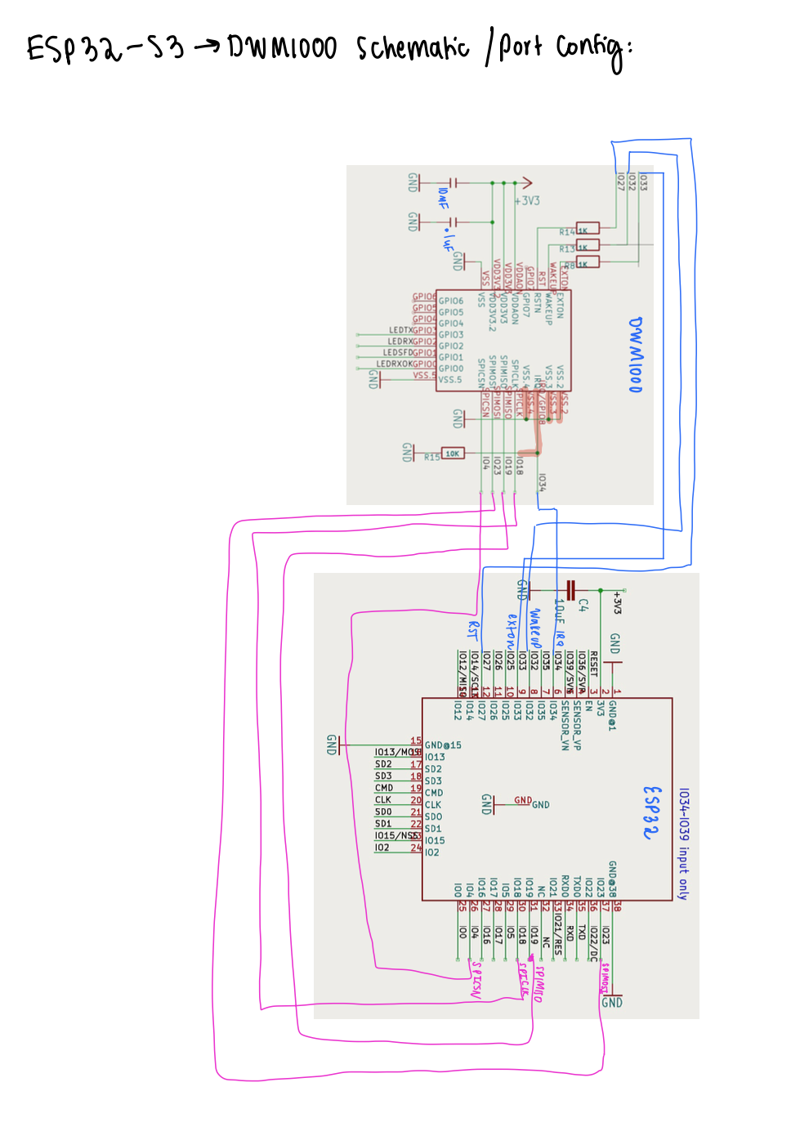
[picture p40: Lab Notebooks/Ramya/Images/Written Notes/Page_4.png]


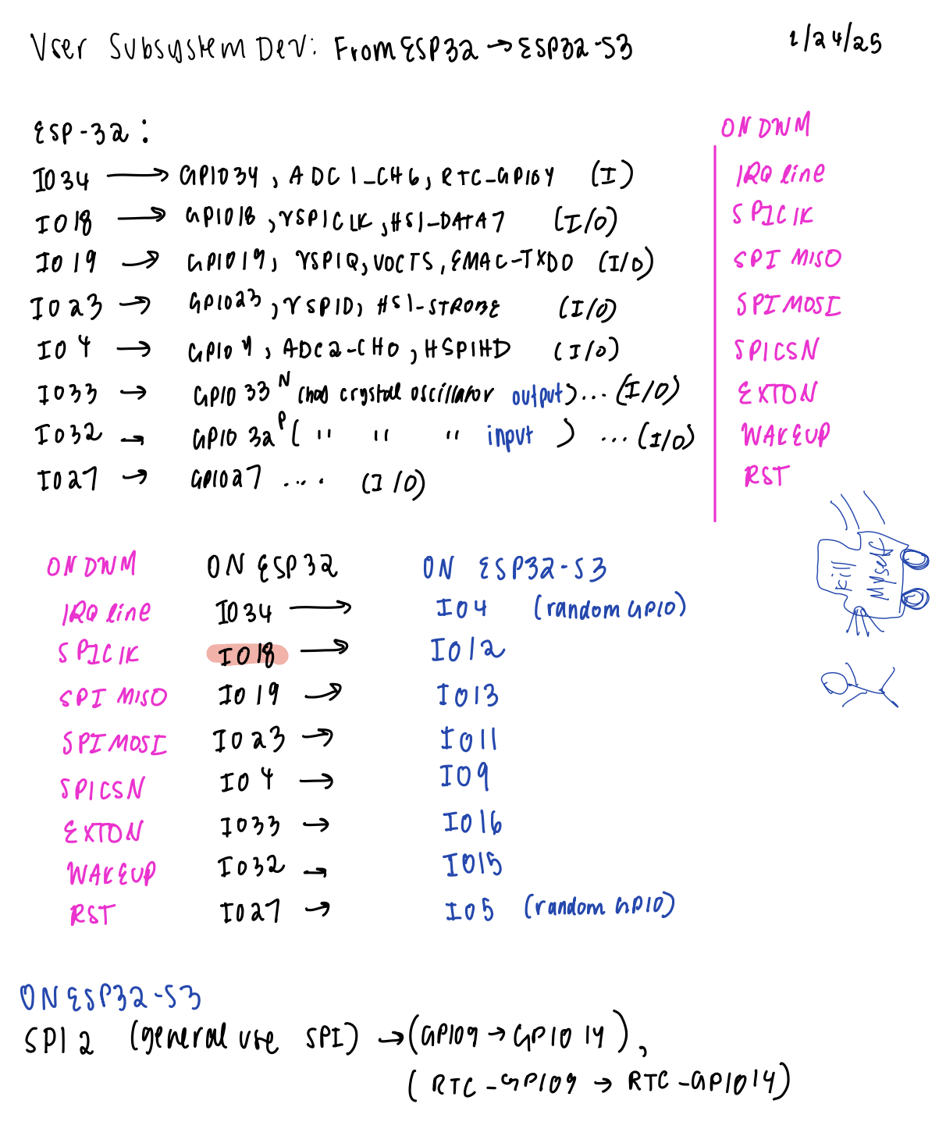
[picture p41: Lab Notebooks/Ramya/Images/Written Notes/Page_5.png]


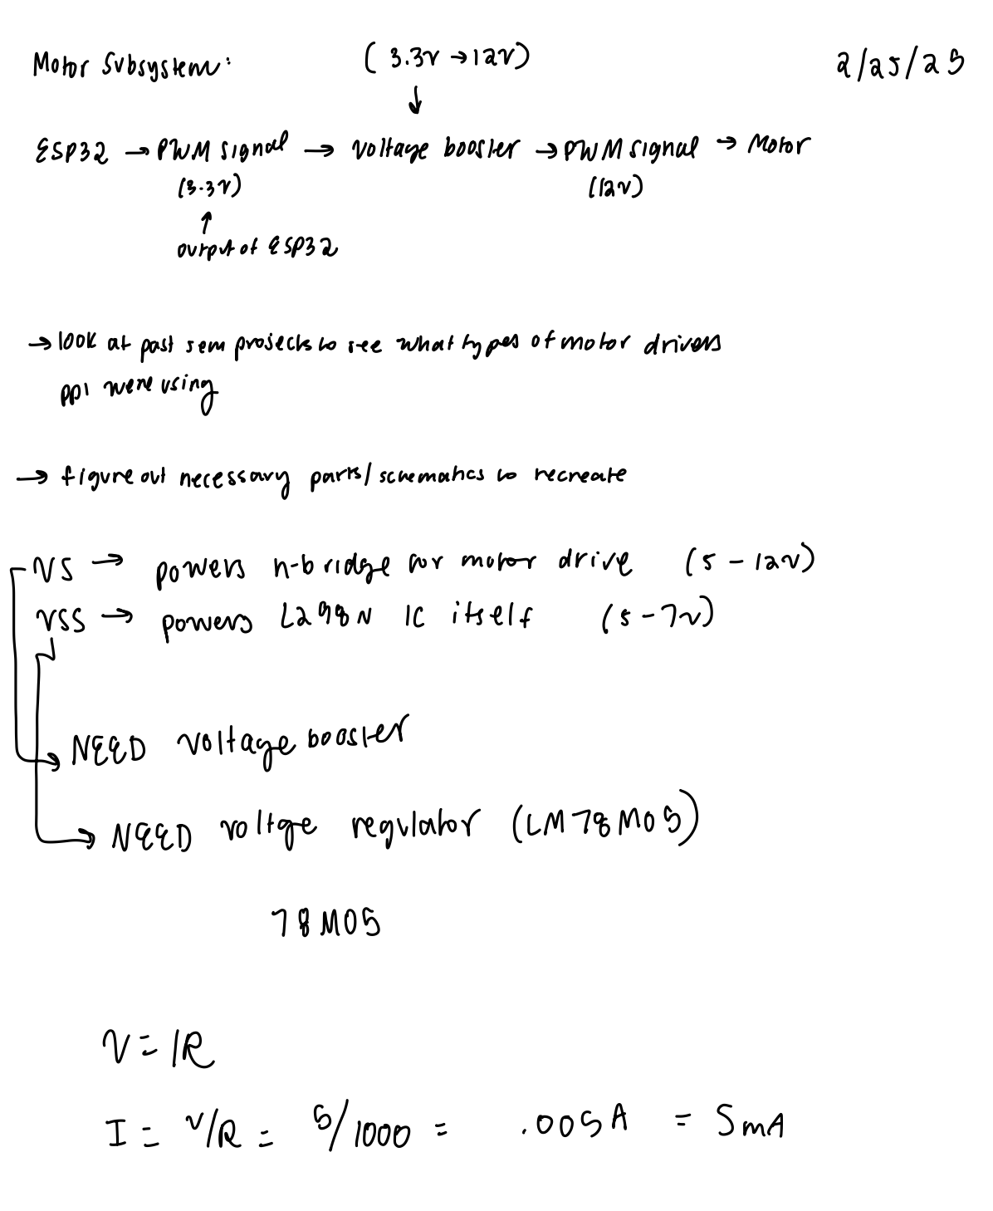
[picture p42: Lab Notebooks/Ramya/Images/Written Notes/Page_6.png]


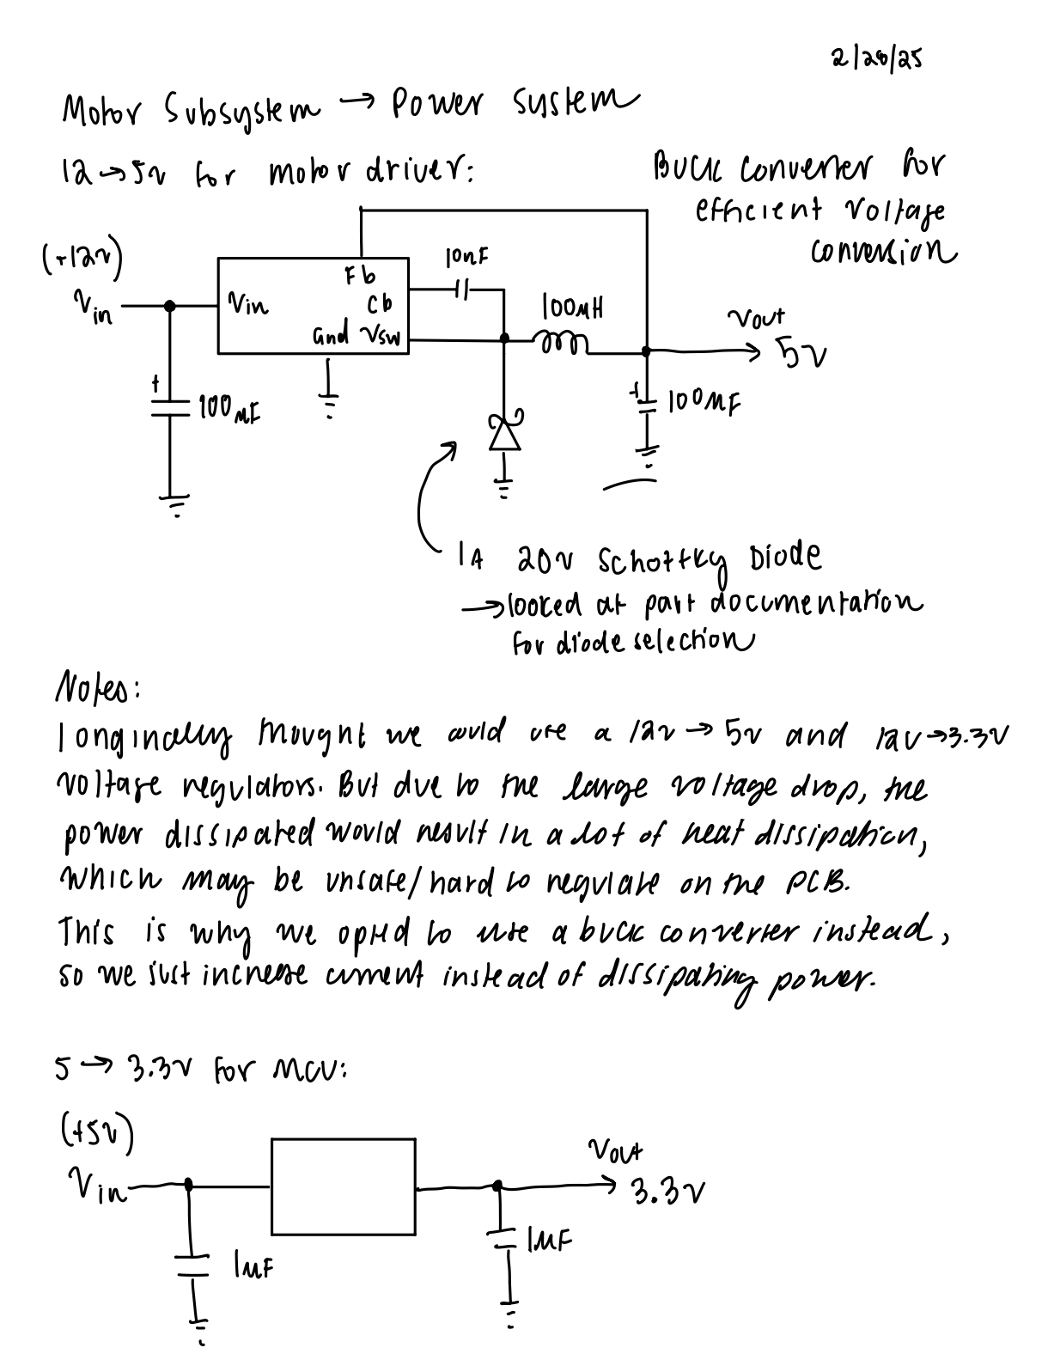
[picture p43: Lab Notebooks/Ramya/Images/Written Notes/Page_7.png]


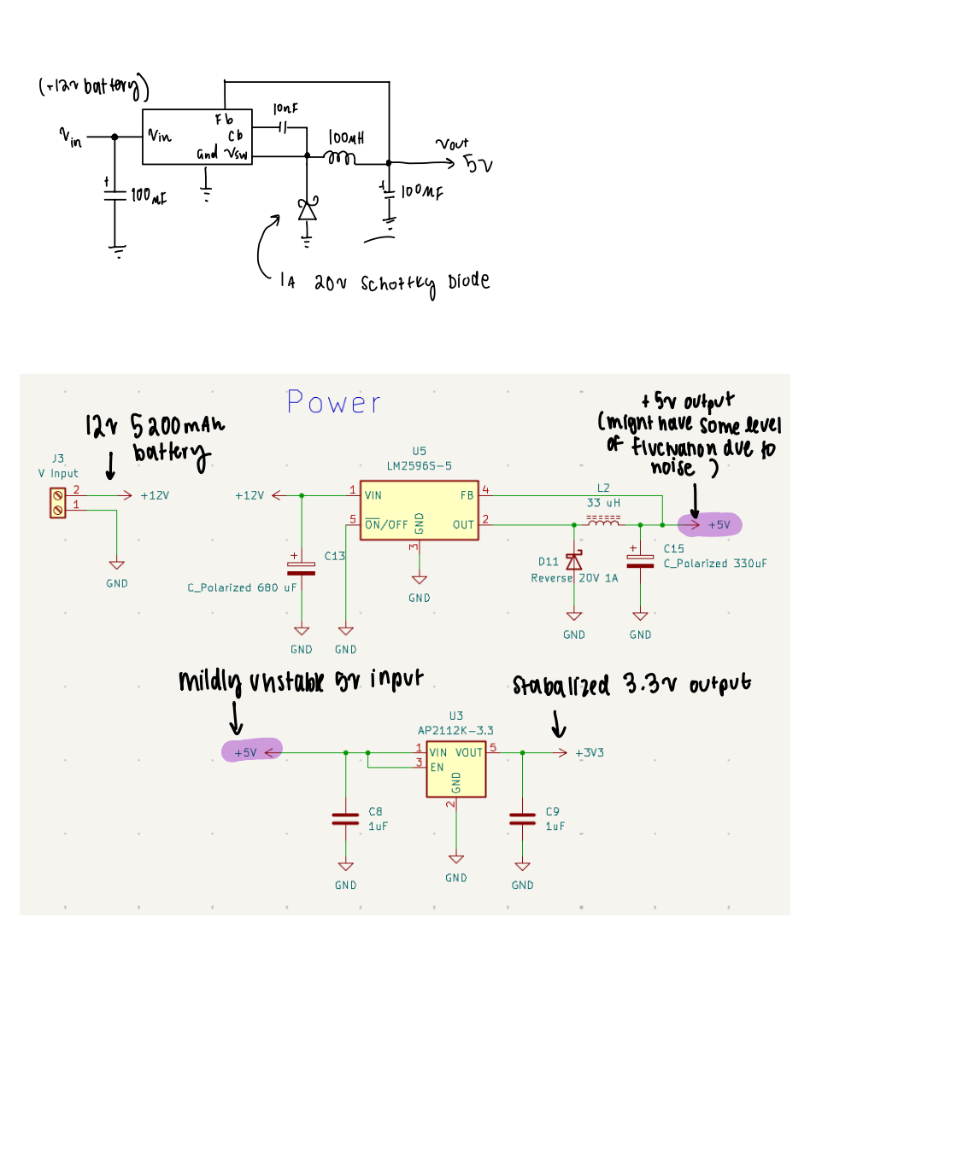
[picture p44: Lab Notebooks/Ramya/Images/Written Notes/Page_8.png]


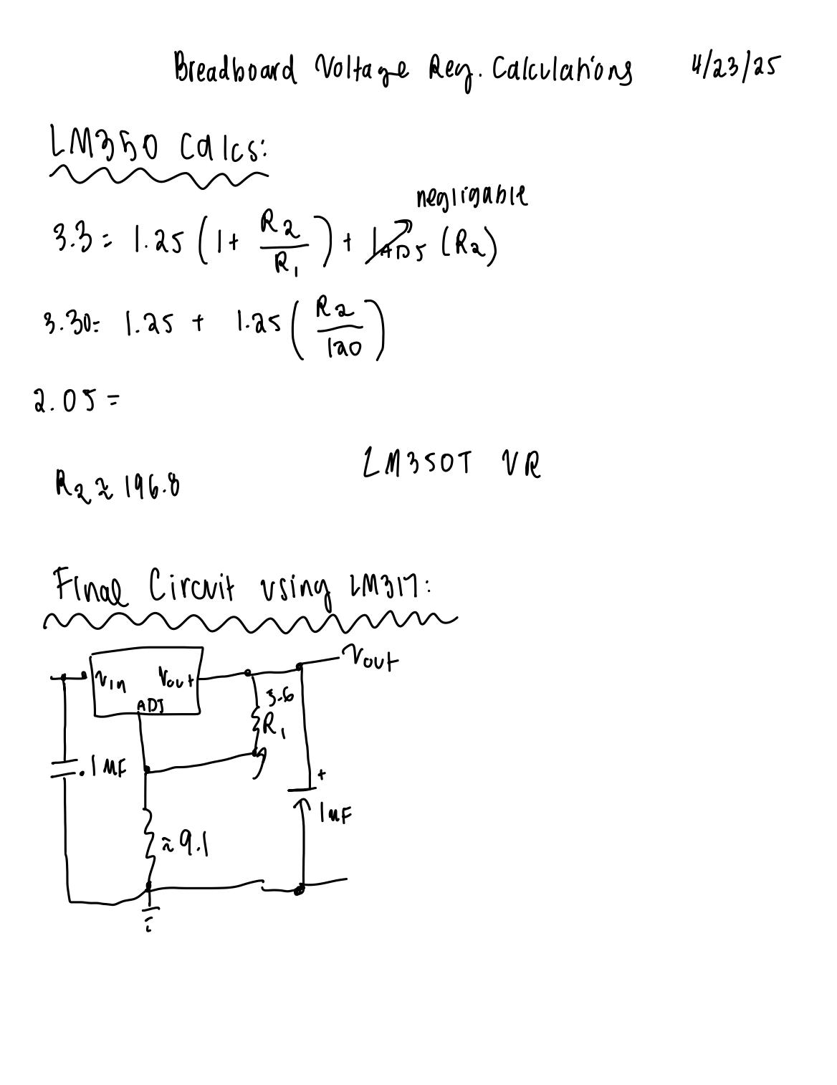
[picture p45: Lab Notebooks/Ramya/Images/Written Notes/Page_9.png]


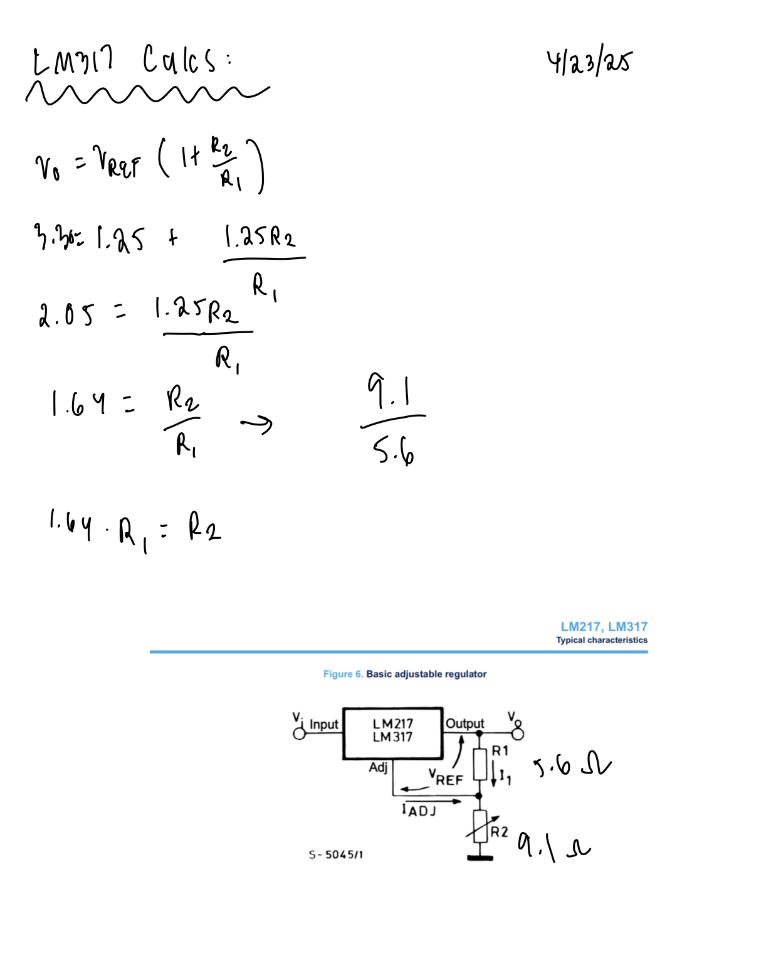
[picture p46: Lab Notebooks/Ramya/Images/Written Notes/Page_10.png]


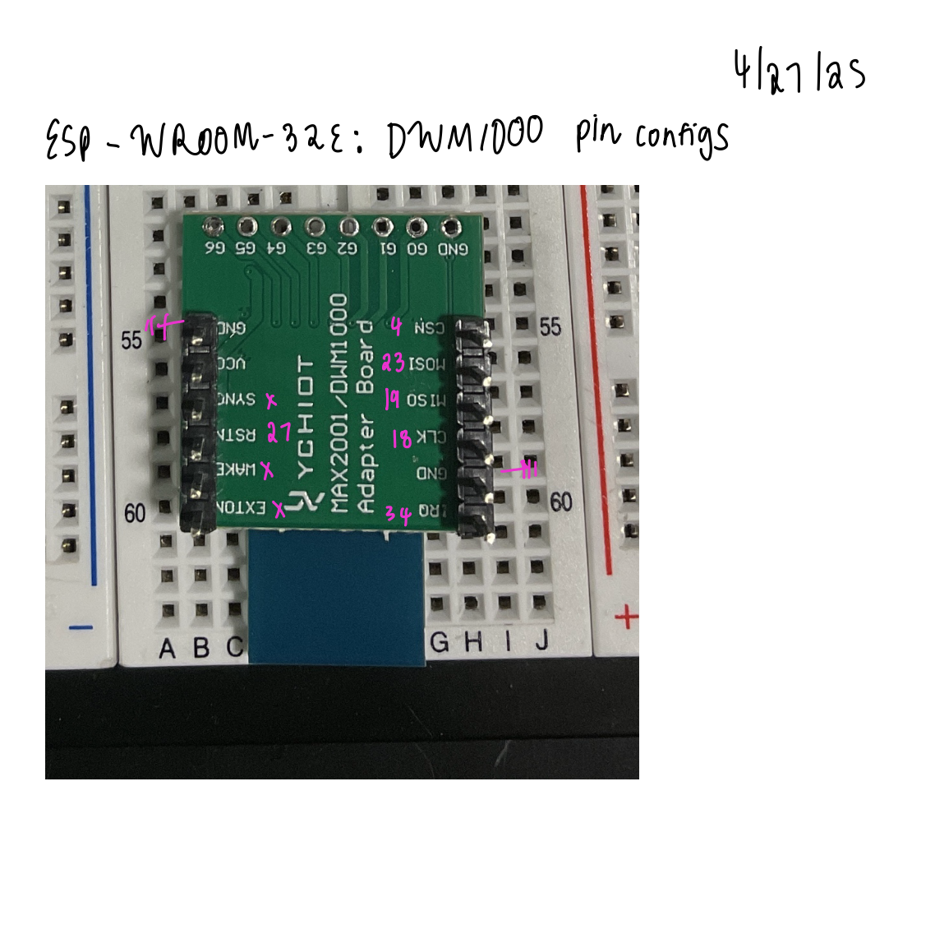
[picture p47: Lab Notebooks/Ramya/Images/Written Notes/Page_11.png]


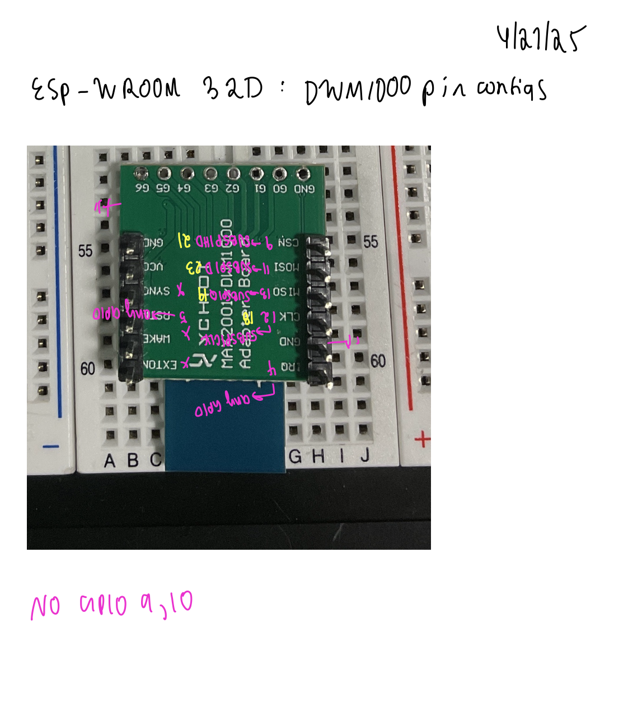
[picture p48: Lab Notebooks/Ramya/Images/Written Notes/Page_12.png]
