nehaej2/ece445_team39/UWB Code/UWB_Anchor_4_6_25/UWB_Anchor_4_6_25.ino

/*

For ESP32 UWB or ESP32 UWB Pro

*/

#include <SPI.h>
#include "DW1000Ranging.h"

#define ANCHOR_ADD "86:17:5B:D5:A9:9A:E2:9C"

#define SPI_SCK 12
#define SPI_MISO 13
#define SPI_MOSI 11
#define DW_CS 9

// connection pins
const uint8_t PIN_RST = 5; // reset pin
const uint8_t PIN_IRQ = 4; // irq pin
const uint8_t PIN_SS = 9;   // spi select pin

void setup()
{
    Serial.begin(115200);
    delay(1000);
    //init the configuration
    SPI.begin(SPI_SCK, SPI_MISO, SPI_MOSI);
    DW1000Ranging.initCommunication(PIN_RST, PIN_SS, PIN_IRQ); //Reset, CS, IRQ pin
    //define the sketch as anchor. It will be great to dynamically change the type of module
    DW1000Ranging.attachNewRange(newRange);
    DW1000Ranging.attachBlinkDevice(newBlink);
    DW1000Ranging.attachInactiveDevice(inactiveDevice);
    //Enable the filter to smooth the distance
    //DW1000Ranging.useRangeFilter(true);

    //we start the module as an anchor
    // DW1000Ranging.startAsAnchor("82:17:5B:D5:A9:9A:E2:9C", DW1000.MODE_LONGDATA_RANGE_ACCURACY);

    DW1000Ranging.startAsAnchor(ANCHOR_ADD, DW1000.MODE_LONGDATA_RANGE_LOWPOWER, false);
    // DW1000Ranging.startAsAnchor(ANCHOR_ADD, DW1000.MODE_SHORTDATA_FAST_LOWPOWER);
    // DW1000Ranging.startAsAnchor(ANCHOR_ADD, DW1000.MODE_LONGDATA_FAST_LOWPOWER);
    // DW1000Ranging.startAsAnchor(ANCHOR_ADD, DW1000.MODE_SHORTDATA_FAST_ACCURACY);
    // DW1000Ranging.startAsAnchor(ANCHOR_ADD, DW1000.MODE_LONGDATA_FAST_ACCURACY);
    // DW1000Ranging.startAsAnchor(ANCHOR_ADD, DW1000.MODE_LONGDATA_RANGE_ACCURACY);
}

void loop()
{
    DW1000Ranging.loop();
}

void newRange()
{
    Serial.print("from: ");
    Serial.print(DW1000Ranging.getDistantDevice()->getShortAddress(), HEX);
    Serial.print("\t Range: ");
    Serial.print(DW1000Ranging.getDistantDevice()->getRange());
    Serial.print(" m");
    Serial.print("\t RX power: ");
    Serial.print(DW1000Ranging.getDistantDevice()->getRXPower());
    Serial.println(" dBm");
}

void newBlink(DW1000Device *device)
{
    Serial.print("blink; 1 device added ! -> ");
    Serial.print(" short:");
    Serial.println(device->getShortAddress(), HEX);
}

void inactiveDevice(DW1000Device *device)
{
    Serial.print("delete inactive device: ");
    Serial.println(device->getShortAddress(), HEX);
}
