nehaej2/ece445_team39/(commit log)

2025-04-16 Anntenna calibration for UWB 4/14
2025-04-17 Antenna Delay Callibration added to main anchor code
2025-04-27 Kalman filter code for UWB written. Needs testing
2025-04-28 slight modification to kalman filter code WIP
2025-04-29 UWB distance data filtering done
2025-04-29 finished bluetooth integration w filtering
2025-04-29 Motor movement code from 4/28 night
